Exequiel25/Mezclador-de-4-canales-y-Amplificador-de-3W/README.md

# Mezclador-de-4-canales-y-Amplificador-de-3W
