Exequiel25/Mezclador-de-4-canales-y-Amplificador-de-3W/Proyecto Final EA2-Magni Genre,Exequiel Juan.docx

DEPARTAMENTO ELECTRONICA DE LA FACULTAD REGIONAL MENDOZA

UNIVERSIDAD TECNOLOGICA NACIONAL

UNIVERSIDAD TECNOLÓGICA NACIONAL

Facultad Regional Mendoza

Departamento de Electrónica

Cátedra: Electrónica Aplicada II

“Mezclador de audio con 4 canales,

amplificador de potencia de 3W”

Alumno: Exequiel Juan Magni Genre

N.º Legajo: 46229

Docente titular: Ing. Moyano, Roberto

AÑO 2025

# 1 Definición del problema

Como parte de los requerimientos de aprobación y/o regularización de la materia Electrónica aplicada II se plantea la necesidad de construir un sistema que plasme/aplique los conocimientos adquiridos en dicha materia. Dicho trabajo deberá ser presentado funcionando (simulado) y con su respectivo informe.

## 1.1 Solución propuesta

Construcción de un mezclador de 4 canales e integrarlo con un amplificador de audio. La potencia máxima de diseño para el amplificador de potencia es de 3 Watts valor eficaz.

## 1.2 Justificación

El proyecto abarca gran parte del contenido y conceptos del programa analítico de la materia. Por lo que resulta una buena opción como tema de trabajo final.

Temas incluidos:

- Tema 1: Amplificadores Realimentados
- Tema 2 y 3: Amplificadores Operacionales
- Tema 5: Respuesta en frecuencia
- Tema 6: Amplificadores de Potencia
- Tema 7: Fuentes de alimentación regulada

## 1.3 Objetivos

- Integrar y aplicar los conceptos vistos en la materia y en otras también.

## 1.4 Alcances y limitaciones

El proyecto consistirá en un mezclador de audio y un amplificador de potencia a su salida, ya que un amplificador operacional no sería capaz de suministrar al parlante la corriente necesaria para la excitación de la bobina.

El mezclador deberá ser capaz de manejar entradas de micrófono balanceados, instrumentos musicales y entradas de audio auxiliares (computadoras, celulares, reproductores, etc.). Para este informe y simulación, se realizará el diseño de un canal completo, es decir, con entradas de micrófono, instrumentos, auxiliares y de línea, pero este proyecto puede ser modificado para que cada canal sea más específico a la entrada que se desea.

El amplificador de potencia desarrolla una potencia máxima eficaz de 3W (Watts) sobre un parlante equivalente a una carga de 8Ω (Ohm).

También se debe considerar agregar un amplificador para auriculares cuando el operador desea escuchar la señal de audio de cada canal.

## 1.5 Diagrama de bloques

Figura 1.5.1: Diagrama de bloques general

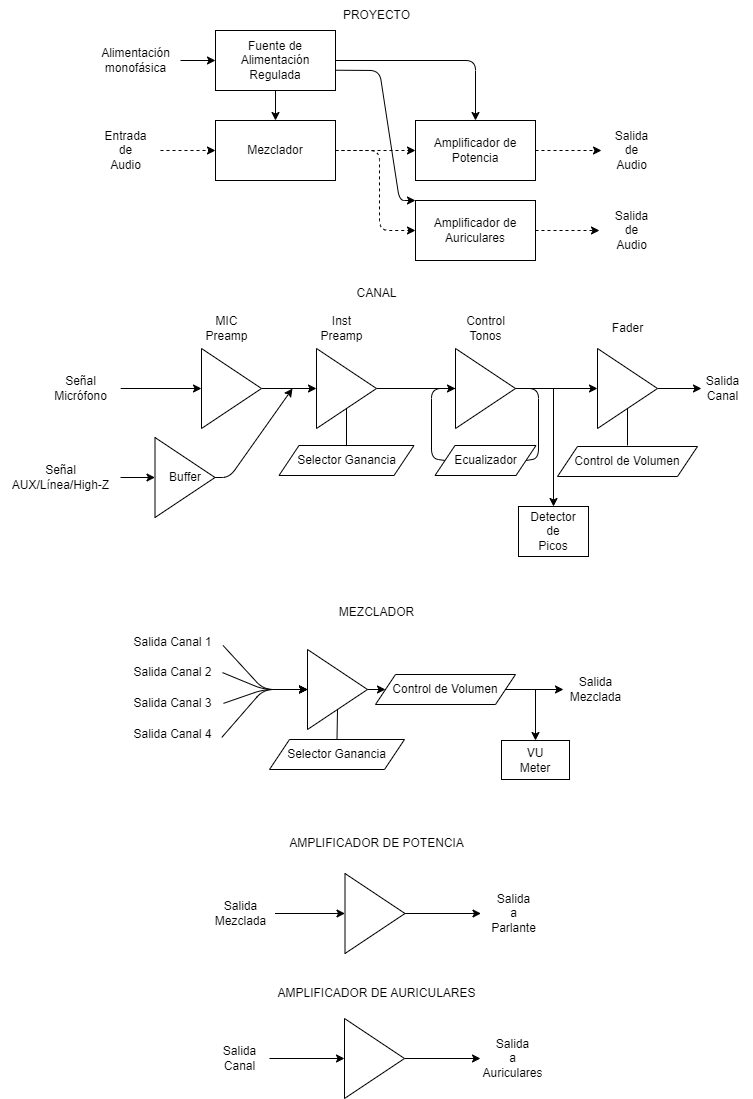
[picture p1: figure]

Figura 1.5.2: Diagrama de bloques fuente de alimentación

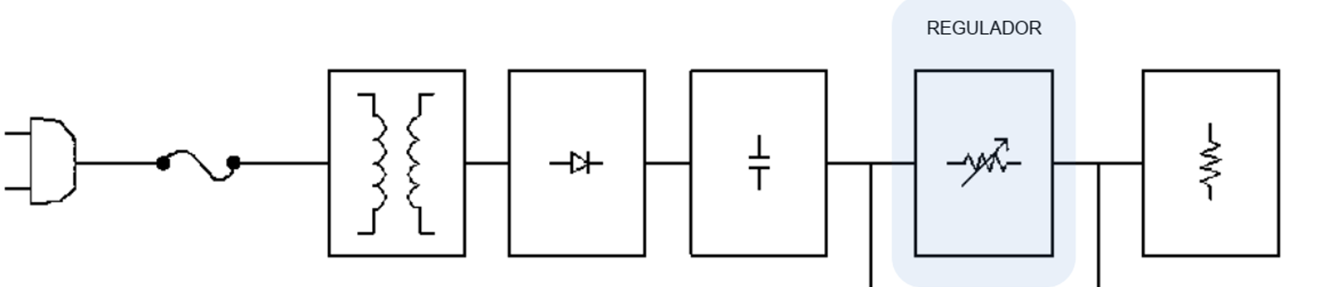
[picture p2: figure]

Figura 1.5.3:Diagrama de bloques en KiCad

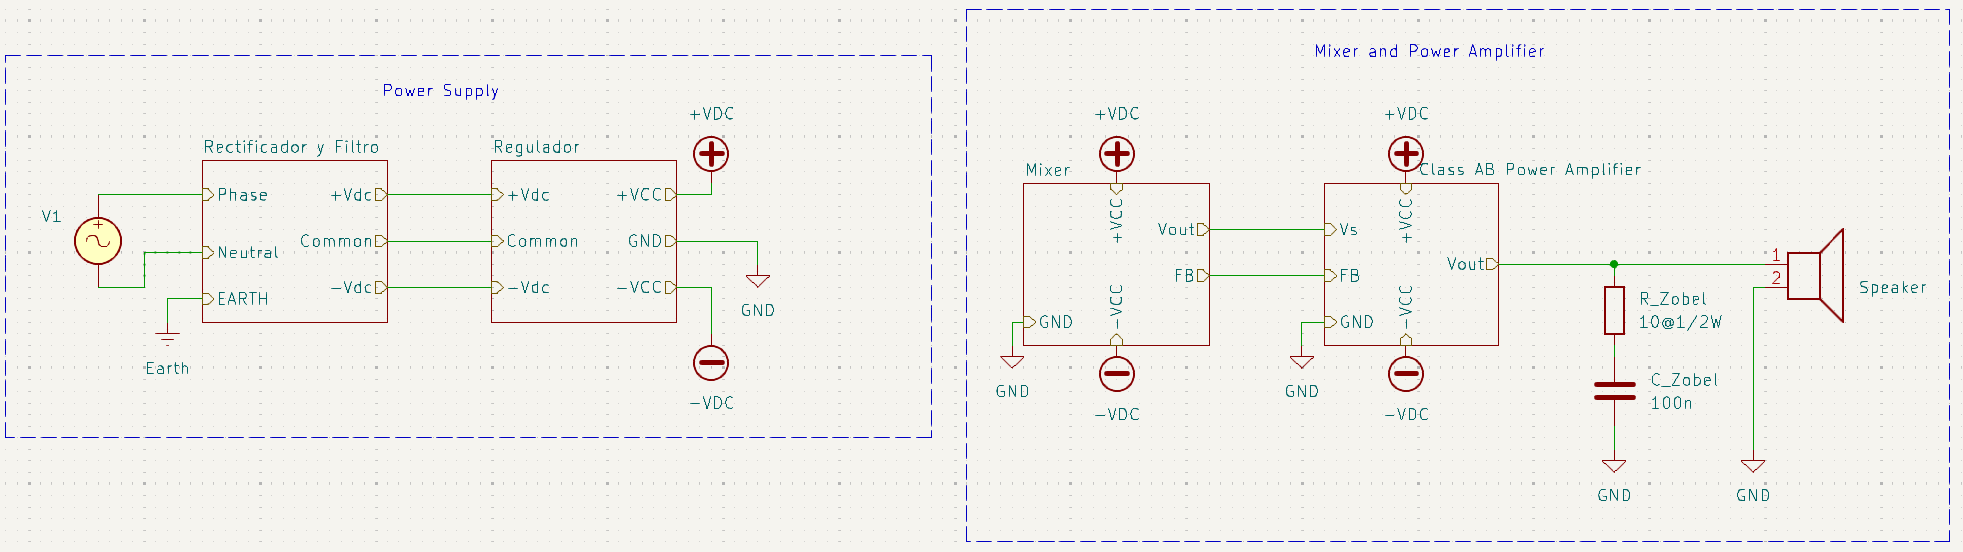
[picture p3: figure]

Figura 1.5.4: Diagrama de bloques de un canal completo

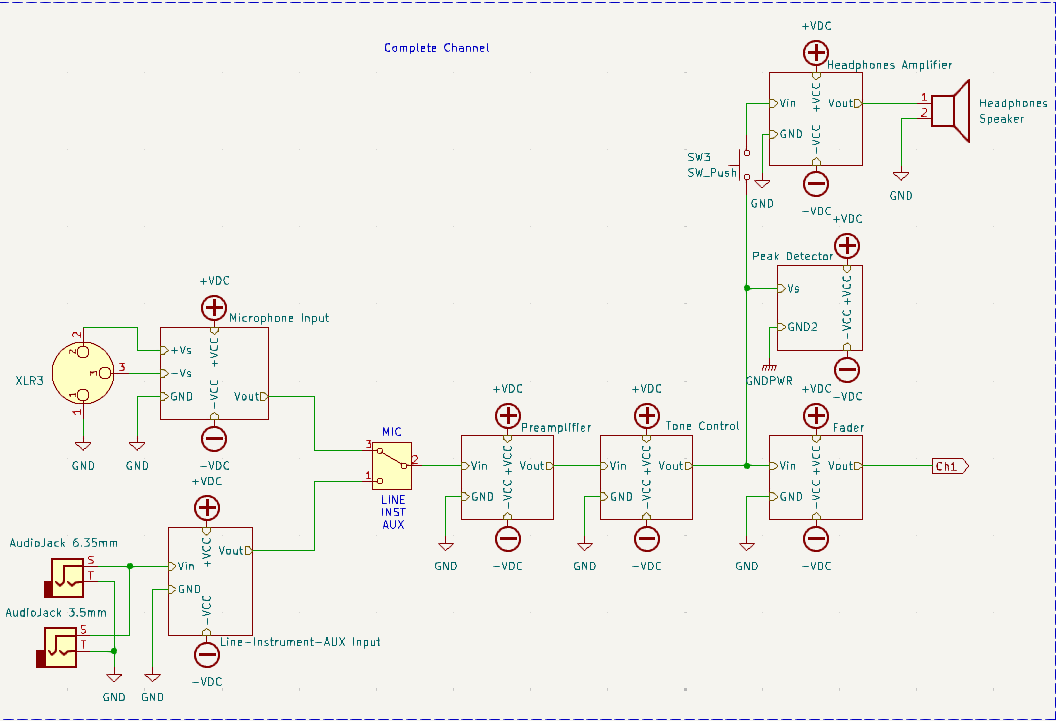
[picture p4: figure]

Figura 1.5.5: Diagrama de bloques etapa sumadora

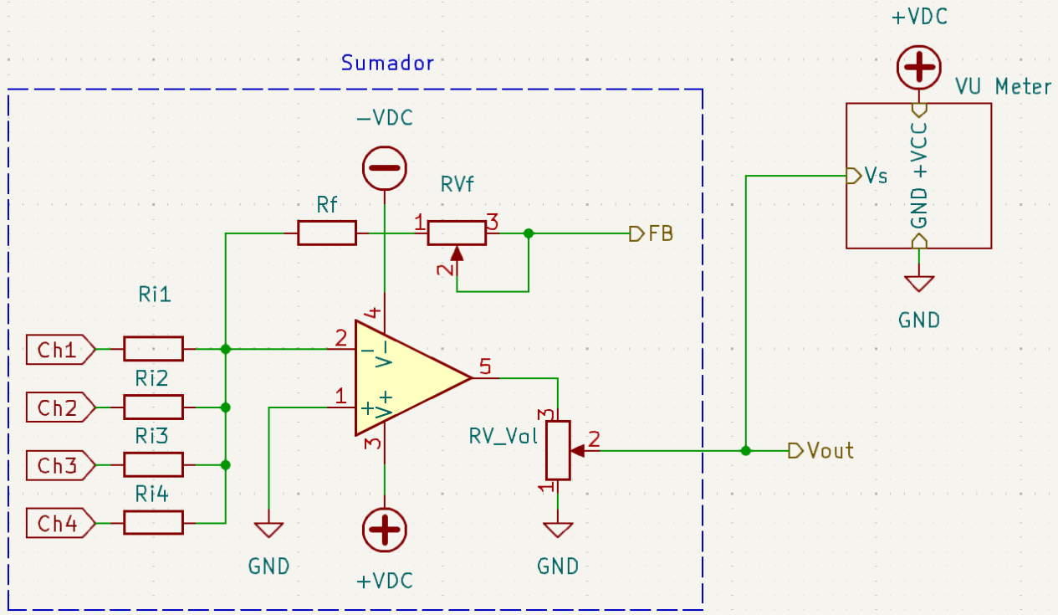
[picture p5: figure]

# 2 Pre-Diseño

## 2.1 Parámetros y consideraciones técnicas

En el desarrollo del proyecto, se realizó una investigación en la construcción de consolas mezcladoras comerciales. De allí, se logró plantear un circuito que cumpla con expectativas y estándares comerciales.

ETAPA ENTRADA

GUITARRA

(eléctrica o

acústica)

CARGA

8 Ω

### 2.1.1 Fuente de alimentación

La fuente que alimenta a los amplificadores no debería ser conmutada, ya que estas introducen ruido en las señales de audio. Por este motivo, se debe optar por una fuente regulada no conmutada.

### 2.1.2 Selección de componentes electrónicos

Al momento de la selección de los componentes electrónicos, se debe buscar que estos no introduzcan ruido al sistema, especialmente en la elección de los amplificadores operacionales, los cuales en sus fichas técnicas suelen indicar el valor de SNR (Relación Señal-Ruido) o indican el nivel de ruido respecto a la señal de entrada.

También se evita en el diseño utilizar resistencias de valores elevados, ya que las mismas introducen ruido térmico al sistema.

### 2.1.3 Valores de tensión

Existen valores estandarizados de tensión, definidos como niveles:

- Nivel de línea: suele ser de -10 dBV (nominal) o +4 dBu (profesional)
- Nivel de micrófonos: es la más débil, entre -60 dBu y -20 dBu
- Nivel de instrumentos: entre -20 dBu y -10 dBu
- Nivel de señal AUX (auxiliar): entre -3.3 dBu y 1.15 dBu

Recordamos:

dBV (DecibeliosVolts)=20⋅log_10 V

dBu (DecibeliosUnidaddeUnidad)=20⋅log_10 (V/0.775)

### 2.1.4 Ancho de banda:

Debemos respetar el ancho de banda de las señales de audio, el cuál consta de una frecuencia mínima de 20 Hz hasta una frecuencia máxima de 20 kHz (espectro audible), aunque en la práctica, el rango suele ser aproximadamente desde los 50 Hz hasta los 18 kHz. Aun así, buscaremos exigencia en respetar el espectro audible.

### 2.1.5 Amplificador de potencia

Utilizaremos un amplificador de audio clase AB. Si bien la potencia planteada es menor comparada a algunas consolas mezcladoras comerciales (comúnmente 100W), plantearemos un diseño cuyo alcance pueda ser expandido con simples modificaciones, pero respetando la topología.

### 2.1.6 Detector de picos

Para el detector de picos se optó por un diseño de detección bipolar, ya que las señales de audio pueden ser muy asimétricas en amplitud y de este modo podremos detectar picos positivos y negativos.

# 3 Amplificador de Potencia

## 3.1 Especificaciones

El amplificador de potencia tiene como objetivo proveer un valor de corriente capaz de excitar el bobinado del parlante, por lo tanto, podemos considerarlo un amplificador de corriente. Es por esto, que se utiliza una configuración de Colector Común o Seguidor de Emisor.

Deberemos cumplir con los siguientes requerimientos:

Potencia: P_L =3W

Carga: R_L =8Ω

Condiciones de máxima transferencia de energía:

Z_i ≪R_S

Z_o =R_L

Los amplificadores Clase AB (Push-Pull) son uno de los diseños de amplificador de audio más preferidos debido a su combinación de eficiencia y alta calidad ya que tienen baja distorsión cruzada y alta linealidad.

## 3.2 Esquemático

Se plantea como solución el siguiente circuito:

Figura 3.2.1:Amplificador de audio clase AB

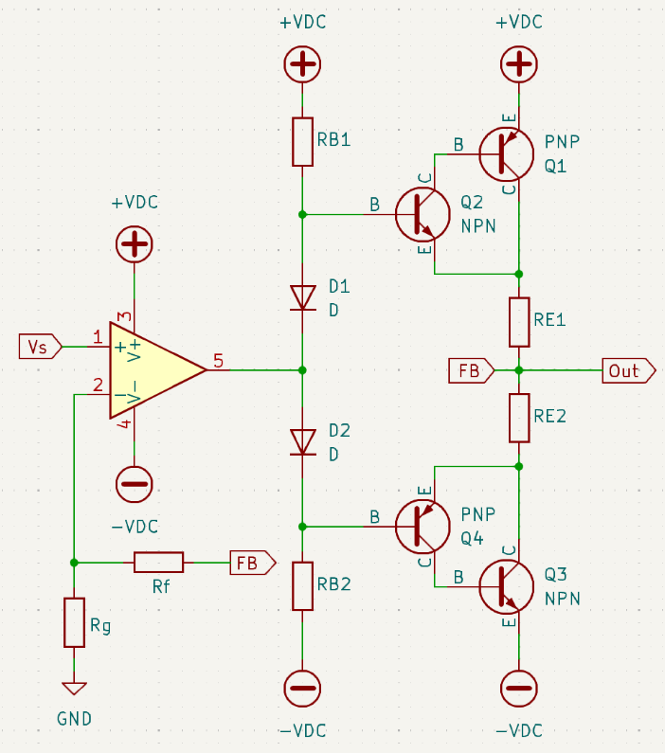
[picture p6: figure]

## 3.3 Observaciones

Utilizamos dos pares Sziklai (o pares complementarios) para reducir el valor de corriente de polarización y de señal extraída desde el amplificador operacional.

Añadimos dos resistencias (RE1 y RE2) para evitar un embalamiento térmico.

Unimos la red de realimentación del amplificador operacional a la salida del amplificador de potencia para compensar las alinealidades y las caídas de tensión irregulares en los diodos y junturas, así aseguramos un nivel nulo de continua en la salida.

## 3.4 Cálculo

### 3.4.1 Potencia en la carga

Primero determinamos los valores de tensión y corriente en la carga.

| P_L =(V_L^2)/(R_L)=I_(L_max)^2 ∙R=3W | (1)
| V_(L_max) ≈4.9V≈6.93V_p | (2)
| I_(L_max) ≈0.61A≈0.87A_p | (3)

Consideramos que V_(cc) ≥V_(L_max) , debido a que V_(cc) es el máximo nivel de desviación en la carga y, por lo tanto, podríamos seleccionar una fuente de 5V. Sin embargo, como utilizaremos la misma fuente tanto para el amplificador de potencia, como para los amplificadores, se decide una tensión de fuente de V_(cc) =±15V .

### 3.4.2 Análisis de Corriente Alterna

Para el diseño de esta etapa recordamos que, para la configuración de seguidor de emisor, la ganancia de tensión es unitaria A_v ≈1 , por lo tanto, la tensión de la carga será responsabilidad de la etapa anterior.

- Q1: TIP32C
  - h_(FE_(min)) =25
  - Valores máximos:
    - V_(CE) =40V
    - I_C =3A
- Q2: 2N3904
  - h_(FE_(min)) =100
  - Valores máximos:
    - V_(CE) =40V
    - I_C =200mA
- Q3: TIP31C
  - h_(FE_(min)) =25
  - Valores máximos:
    - V_(CE) =40V
    - I_C =3A
- Q4: 2N3906
  - h_(FE_(min)) =100
  - Valores máximos:
    - V_(CE) =40V
    - I_C =200mA

Cuando el par Sziklai superior esté polarizado, el inferior estará en reposo. Por lo que podemos partir de esa suposición para comenzar el análisis. Desde la malla de salida, podemos decir que la corriente de carga será la corriente de emisor del par Sziklai,

| I_(L_p) =I_(E1) ≈0.87A | (4)

Además, podemos conocer la corriente de base, a partir del valor de ganancia de corriente del transistor.

| β_(Sziklai) =β_(Q1) ⋅β_(Q2) +β_(Q1) | (5)

Si tomamos los valores mínimos que figuran en las hojas de datos:

| β_(Sziklai) =25*100+25=2525 | (6)

Por lo tanto,

| I_(B1) =(I_(E1))/(β_(Sziklai))=(0.87A)/2525≈344.55μA | (7)

Si asumimos que, por los diodos, habrá una circulación de 1mA :

| I_(Bias) =I_(B1) +I_D =344.55μ+1mA≈1.34mA | (8)

Debemos ahora calcular la tensión en la base:

| V_D =V_(L_p) -V_(RE1) -V_(Sziklai) | (9)
| V_D =6.93V-(0.87A⋅0.33Ω)-0.7V=5.94V | (10)

Ahora podemos calcular el valor de R_(B1) como:

| R_(B1) =(V_(CC) -V_D)/(I_(Bias)) | (11)
| R_(B1) =(15V-5.94V)/(1.34mA)≈6761Ω→6.8kΩ | (12)

De manera análoga para el par Sziklai inferior:

| R_(B2) =R_(B1) =6.8kΩ | (13)

## 3.5 Simulación

Simularemos únicamente la etapa sin realimentación con el sumador, ya que este aún no está diseñado. Luego, se realizará la simulación correspondiente con ambas etapas.

Figura 3.5.1

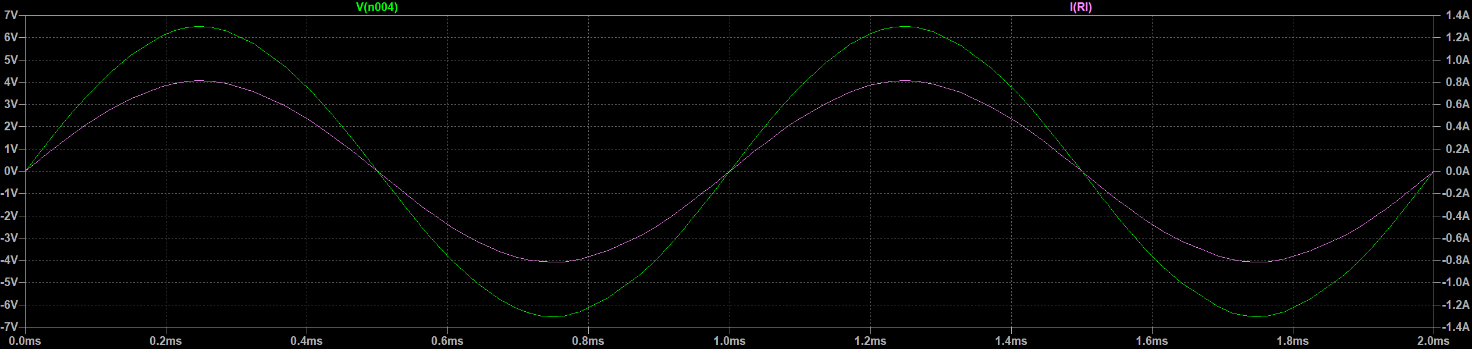
[picture p7: figure]

V_s = 6.93V pico y la salida es V_o = 6.51V pico. Implica Av=0.939, que habrá que compensar adelante. I_o = 813.73mA pico, cuando I_L es 870mA

Figura 3.5.2: Respuesta en frecuencia

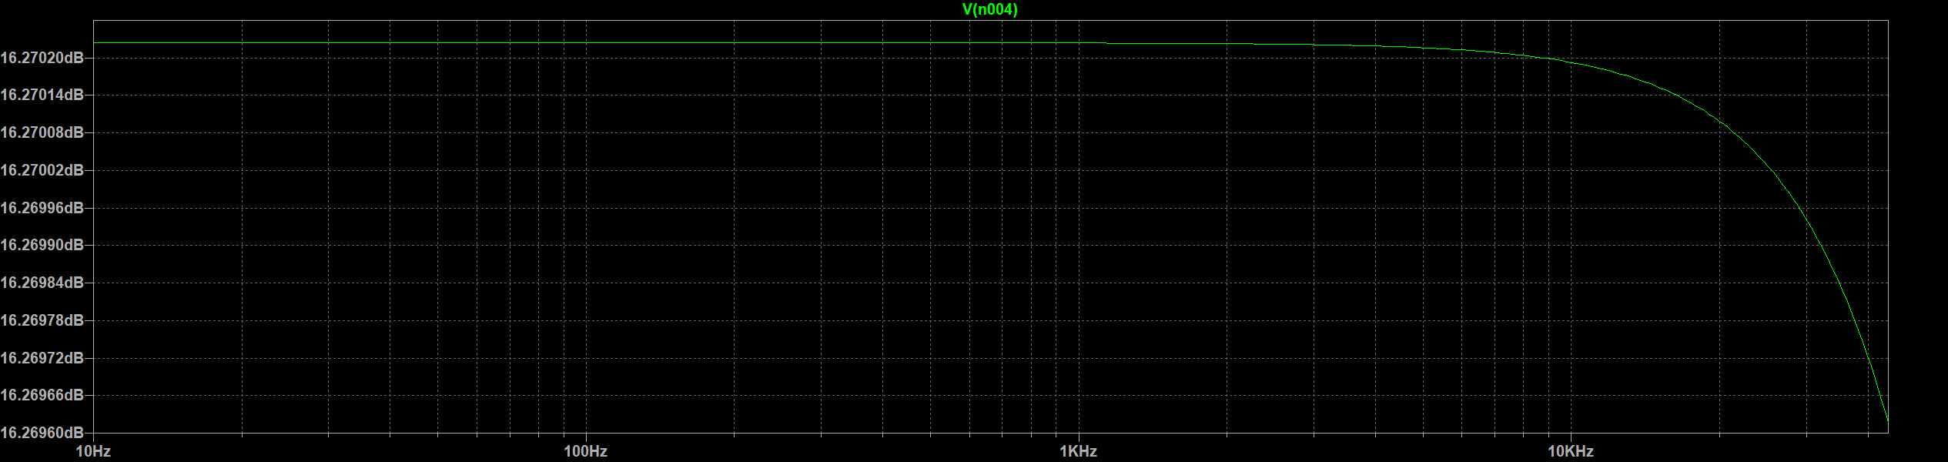
[picture p8: figure]

Como no hemos incorporado capacitores, la respuesta de la etapa tiene un ancho de banda más amplio del establecido.

## 3.6 Resumen de la etapa

Figura 3.6.1: Esquemático resultante

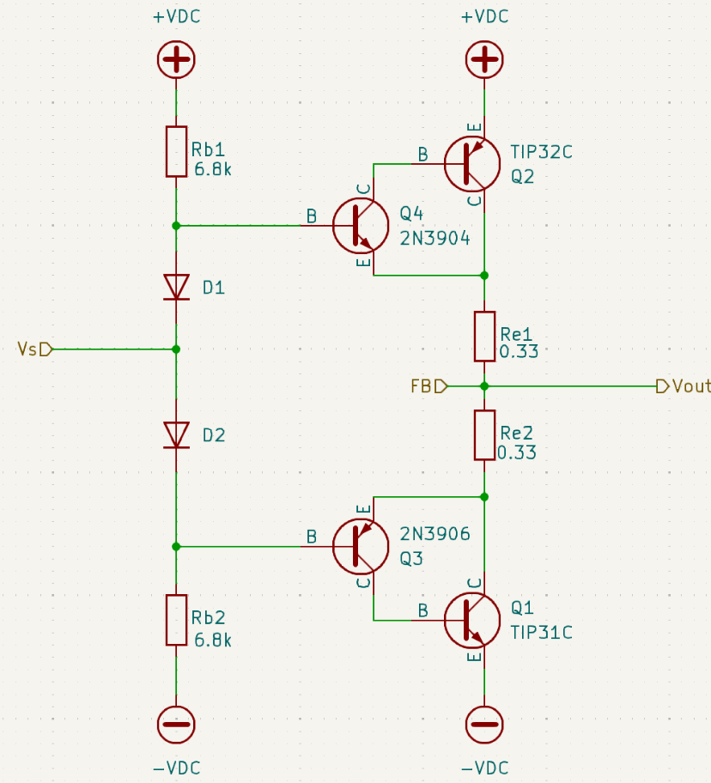
[picture p9: figure]

Tabla 1: Componentes de la etapa

Componente | Valor | Número de Ecuación
R_(e1) ,R_(e2) | 0.33 Ω
R_(b1) ,R_(b2) | 6.8 kΩ | (12)

# 4 Mezclador de Audio (Mixer)

## 4.1 Introducción

Para el diseño del mezclador, se determina de primera instancia qué niveles tienen las señales que han de ser mezcladas, y cuánta ganancia es requerida por canal y a nivel general. Siendo que se utilizarán principalmente entradas de micrófono y de instrumentos, se decide como primera medida, adaptar el nivel de micrófono al nivel de instrumento. De esta forma, se comparte el resto del canal para ambas señales. El objetivo entonces será poder llegar a un nivel de línea luego de la etapa preamplificadora.

Si quisiéramos agregar al canal, entradas auxiliares (AUX) o de línea, podemos hacerlo antes del preamplificador de instrumento.

## 4.2 Sumador “MASTER”

### 4.2.1 Especificaciones

El sumador es la última etapa del mezclador antes del amplificador de potencia. Sabiendo que el amplificador de potencia no tiene ganancia de tensión, implica que la tensión máxima que queremos desarrollar nosotros en la carga, será la tensión máxima de salida del sumador:

v_o =V_L =4V

Si bien veremos que, en la etapa del atenuador (“fader”), se le puede dar un “boost” a la señal, tomaremos como tensión máxima de entrada los 1.228Vrms, equivalentes a la tensión de línea.

### 4.2.2 Esquemático

Figura 4.2.1: Etapa sumador

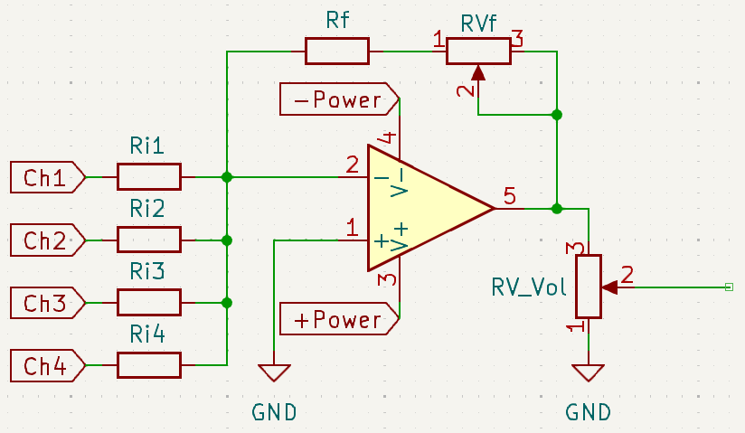
[picture p10: figure]

### 4.2.3 Observaciones

El diseño del sumador es bastante sencillo. El añadido de un potenciómetro en la red de realimentación es el control de ganancia del todos los canales, y el potenciómetro a la salida antes de ingresar a la etapa de potencia controla el volumen general. Una lógica similar será aplicada en cada canal.

### 4.2.4 Cálculo del amplificador

De las especificaciones, sabemos que

| V_(L_(RMS)) =4.9V | (14)
| v_s =1.228V_(RMS) | (15)

Sin embargo, debemos recordar que las señales de cada canal se adicionan, por lo que, para evitar una tensión superior a la deseada para V_(L_(RMS)) , deberemos distribuir la tensión máxima de entrada por canal:

| v_i _(sumador) =(v_s)/(Número Canales) | (16)

Es decir, que cada canal tendrá una tensión de salida de

| v_(o_(canal)) =v_(i_(sumador)) =0.307V_(RMS) | (17)

Esta tensión, la volveremos a utilizar en el diseño del preamplificador.

Debemos recordar que la etapa amplificadora no posee una ganancia de tensión unitaria, como lo vimos en las simulaciones Figura 3.5.1. De todas formas, observaremos lo que ocurre al incluir la red de realimentación a la salida. Si esto no mejora en la simulación, se deberá calcular una ganancia de compensación.

Silenciando todos los canales, para un canal, la ganancia de sumador será

| |G|=(v_o)/(Número Canales⋅v_(s_(ch1))) | (18)

Nuestra ganancia será entonces:

| |G|=(4.9V_(RMS))/(4*0.307V_(RMS))≈3.99→G_(dB) ≈12dB | (19)

Por pedido del usuario, se agrega la posibilidad de atenuar la señal, por lo que el rango de ganancia propuesto es:

| -10dB≤|G_(dB) |≤12 dB→ 0.316≤|G_(dB) |≤3.99 | (20)

Debido a que las impedancias de salida de los canales no serán muy altas, podemos establecer resistencias de entrada de un valor relativamente bajo (para disminuir ruido térmico). Esto a su vez, limita el valor del potenciómetro, el cual tiene una relación proporcional (aumentar el potenciómetro, implica aumentar las resistencias de entrada).

Sabiendo que:

| v_o =-(R_f +R_(Vf) )((V_(ch1))/(R_(i1))+(V_(ch2))/(R_(i2))+(V_(ch3))/(R_(i3))+(V_(ch4))/(R_(i4))) | (21)

Al determinar R_(i1) =R_(i2) =R_(i3) =R_(i4) =R_i , podemos determinar la ganancia para un canal como:

| G=-(R_f +R_(Vf))/(R_i) | (22)

Tenemos el siguiente sistema de ecuaciones:

| , {, -(R_f +R_(Vf))/(R_i)=-3.99, -(R_f)/(R_i)=-0.316 | (23)

Reescribimos:

| , {, R_f -3.99R_i =-R_(Vf) , R_f -0.316R_i =0 | (24)

Elegimos un valor conveniente para R_(V_f) :

| R_(V_f) =10kΩ | (25)

Ahora tenemos un sistema de 2 ecuaciones y 2 incógnitas. Resolviendo:

| R_f ≈860Ω→1kΩ | (26)
| R_i ≈2722Ω→2.7kΩ | (27)

El rango de ganancia con los valores de resistencias comerciales será de:

| 0.29≤|G|≤4.22 | (28)
| , -10.75dB≤G_(dB) ≤12.51dB | (29)

Finalmente, seleccionamos el potenciómetro deslizable para el control de volumen:

| R_(V_(vol)) =10kΩ | (30)

### 4.2.5 Simulación

Observamos todos los valores posibles con las variaciones de R_(V_f) y R_(V_(vol)) , con una señal de entrada en un canal de 0.307V_(RMS) .

Figura 4.2.2: Posibles valores con variaciones de ambos potenciómetros

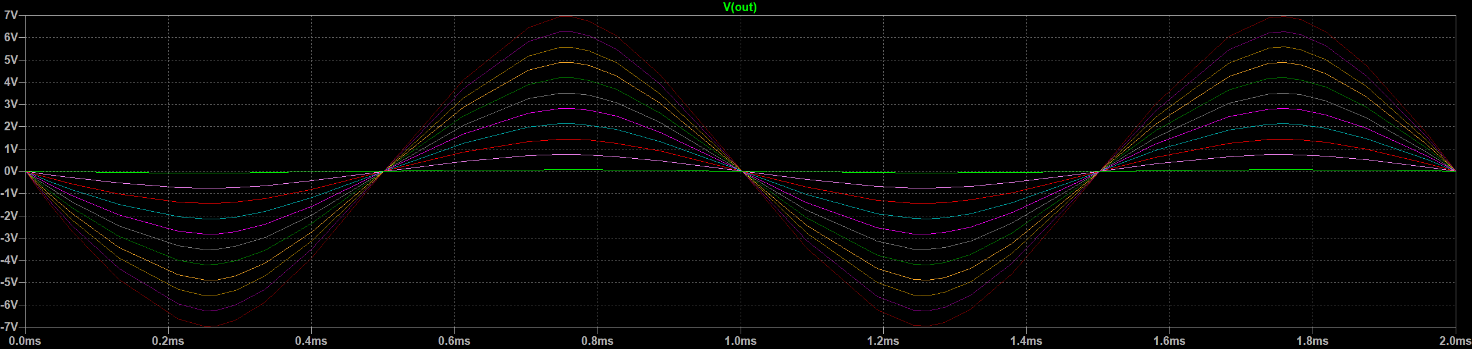
[picture p11: figure]

Valor mínimo 70.22 mV, Valor máximo 6.95 Vp

Figura 4.2.3: Respuesta en frecuencia con variaciones de ambos potenciómetros

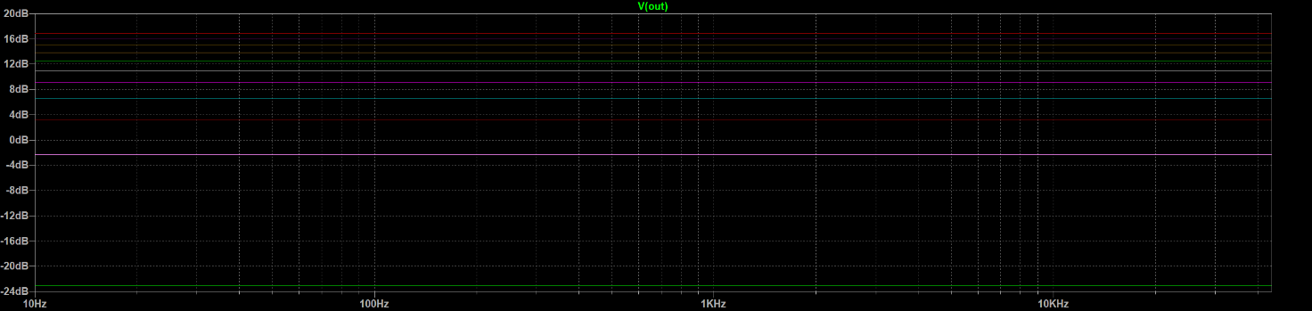
[picture p12: figure]

Vemos también que la respuesta en frecuencia es plana para todas las posibilidades.

También simulamos esta etapa con el Amplificador de Potencia.

Figura 4.2.4: Potencia máxima sobre la carga

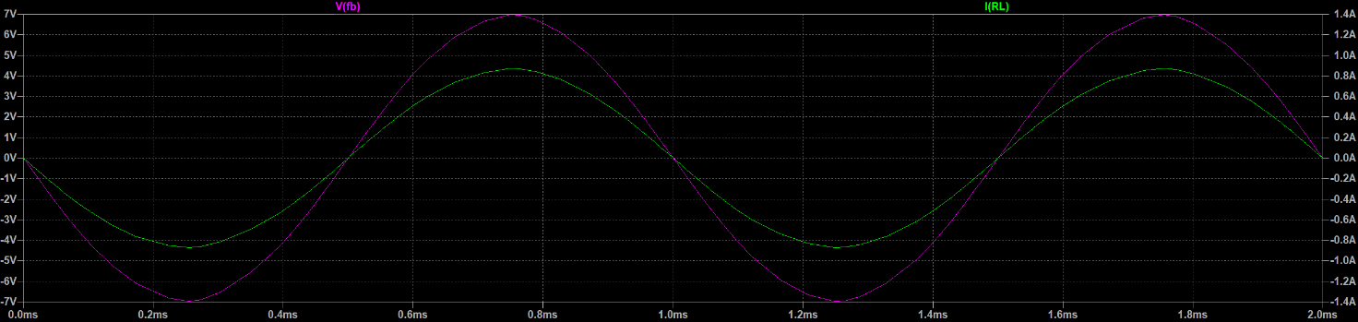
[picture p13: figure]

V_Lmax = 6.96V (por encima de lo deseado), I_Lmax=870.88mA

Confirmamos que los transistores son capaces de disipar la potencia desarrollada en ellos.

Figura 4.2.5:Corriente en resistencias RE1 y RE2

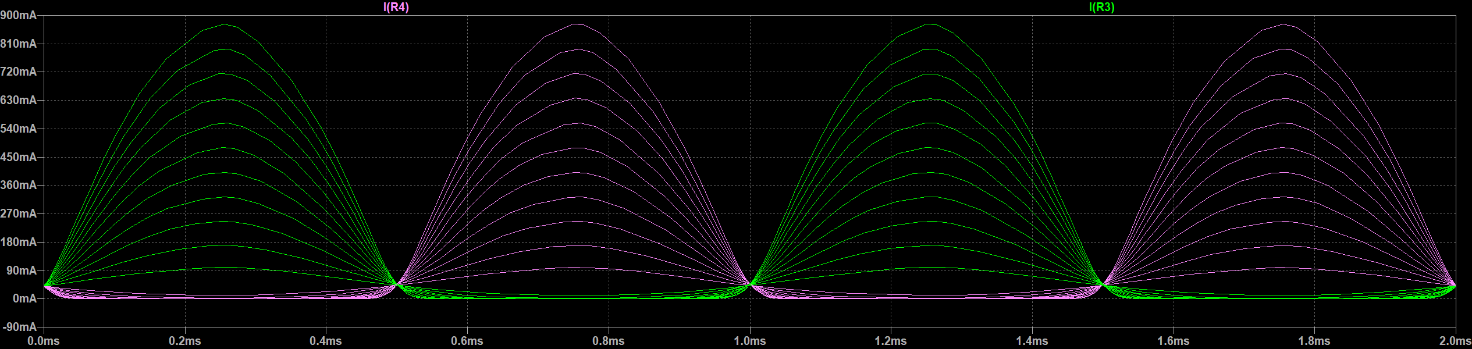
[picture p14: figure]

Figura 4.2.6: Tensiones sobre RE1 y RE2

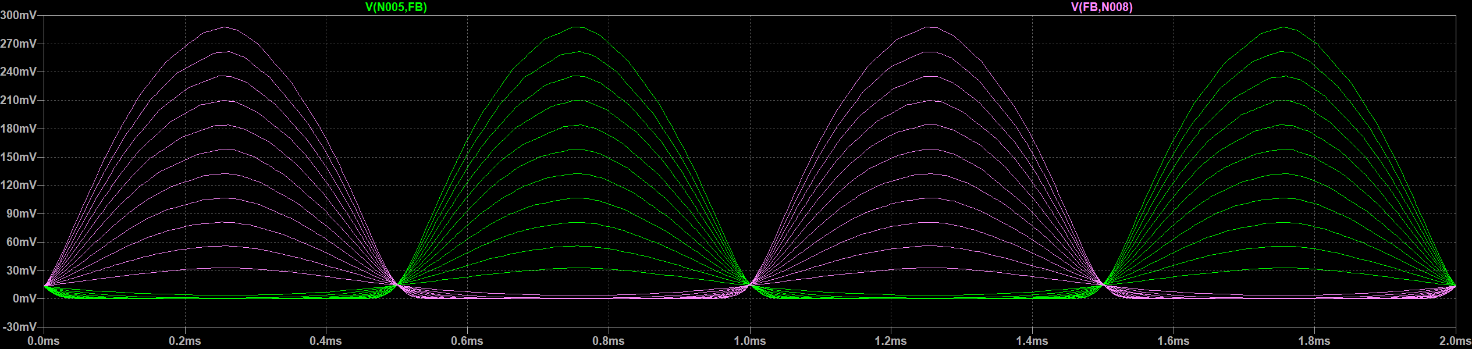
[picture p15: figure]

Figura 4.2.7: Curvas tensión y corriente -Posibles valores

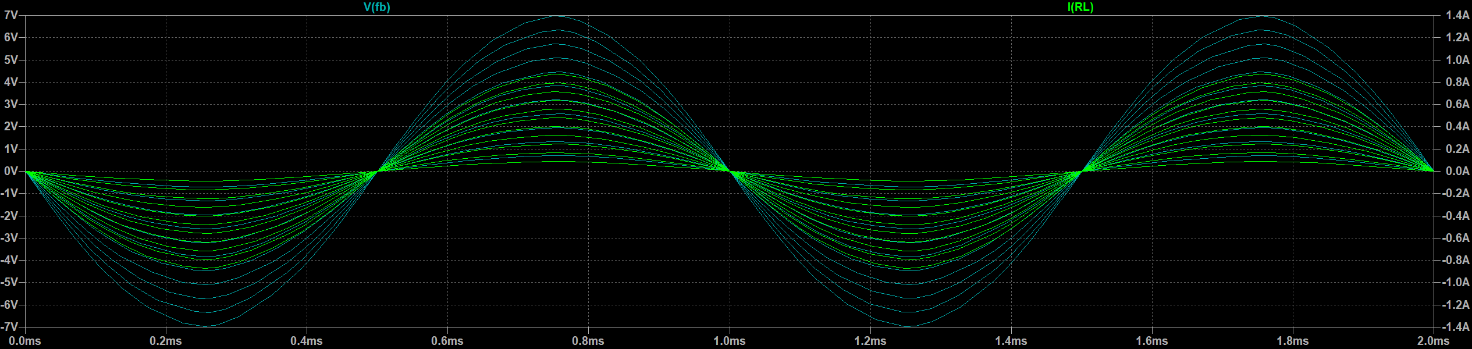
[picture p16: figure]

La potencia máxima por disipar en el par Sziklai 6.74W, con I= 857.02mA, V= 7.87V

### 4.2.6 Resumen de la etapa

Figura 4.2.8: Esquemático resultante

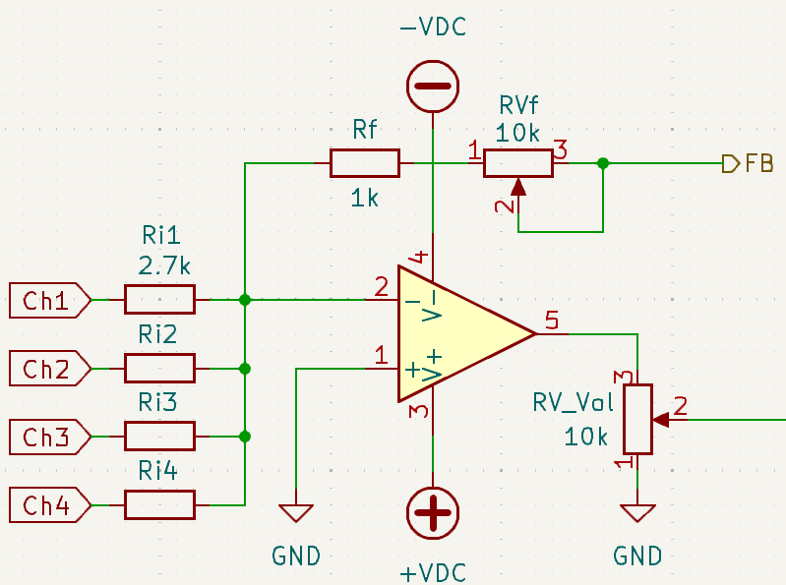
[picture p17: figure]

Tabla 2: Componentes de la etapa

Componente | Valor | Número de Ecuación
R_(i1) , R_(i2) , R_(i3) , R_(i4) | 2.7 kΩ | (27)
R_f | 1 kΩ | (26)
RV_f , RV_(Vol) | 10 kΩ | (25)(30)

## 4.3 Preamplificador de Instrumento (Inst.) + Line + AUX

### 4.3.1 Especificaciones

El preamplificador de instrumentos será útil no sólo para estos, sino también para señales de línea y AUX (auxiliares). Además, para permitir la adaptación a estas señales, se utiliza un op amp buffer a la entrada, por lo que será un preamplificador considerado como “High-Z” (de alta impedancia). Los datos para tener en cuenta en el diseño son:

Tensión de señal:

-30 dBu≤v_s ≤ -10 dBu

es decir,

24.5mV≤v_s ≤245.08mV

34.65 mV≤v_(s_p) ≤346.6mV

Impedancia de señal:

5kΩ≤Z_(Inst) ≤15kΩ

### 4.3.2 Esquemático

Figura 4.3.1: Etapa de entrada y preamplificador

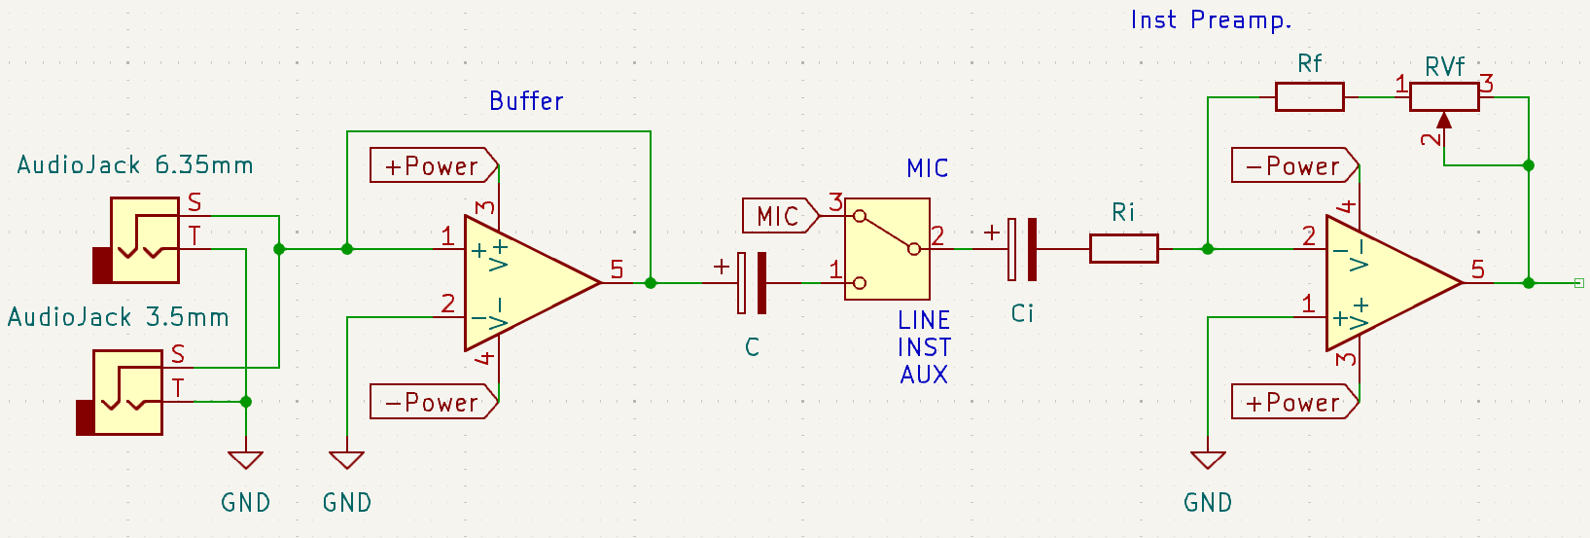
[picture p18: figure]

### 4.3.3 Observaciones

Como se mencionó anteriormente, el buffer a la entrada convierte al canal en uno de alta impedancia (desde el instrumento), lo cual implica una mejor transferencia de tensión. Para evitar problemas entre instrumentos y micrófonos, la conexión al preamplificador se realiza por medio de un switch.

En la solución planteada del preamplificador, no hemos introducido capacitores para determinar el ancho de banda de la etapa, por lo que veremos más adelante cuál es su cálculo.

### 4.3.4 Cálculo

La resistencia R_i es responsable de determinar la impedancia de entrada, nuevamente se encuentra presente la relación de compromiso entre disminuir efectos de carga y mantener bajo ruido. Siendo que la señal fue precedida por una entrada buffer o por el preamplificador balanceado, podemos estimar que la Z_o será de unos pocos ohmios, por lo que podemos determinar un valor beneficioso para el cálculo de ganancia.

| R_i =1kΩ | (31)

Para el cálculo de ganancia, tomamos el peor caso (tensión de señal más bajo) y la máxima tensión que deseamos a la salida. Llevamos la señal desde un nivel de instrumento a un nivel de línea:

| v_s = -30dBu→v_s =24.5mV→v_(s_p) =34.65mV | (32)

Recordando la ecuación (17), nuestra tensión de salida objetivo será

| v_o = 0.307V_(RMS) →v_(o_p) ≈434.16mV→v_o ≈-8dBu | (33)

Por lo tanto:

| |G|≈12.53→|G_(dB) |=21.96dB | (34)

Esta es la ganancia en el caso más desfavorable. Siendo que, en esta etapa, se desea una ganancia variable, debemos determinar el nivel mínimo y máximo de ganancia. Por deseos del usuario, también se debe posibilitar una atenuación de la señal (ganancia entre 0 y 1). El rango de ganancia establecido es:

| -20dB≤|G_(dB) |≤+22dB | (35)

Para nuestro preamplificador:

| | G=-(R_f +R_(Vf))/(R_i) | | (36)
| , {, R_f -12.59R_i =-R_(Vf) , R_f -0.1R_i =0 | | (37)

Elegimos un valor conveniente para R_(V_f) :

| R_(Vf) =50kΩ | (38)

Resolviendo (37):

| R_f ≈400Ω→390Ω | (39)
| R_i ≈4003Ω→3.9kΩ | (40)

Recalculando el intervalo de ganancia:

| 0.1≤|G|≤12.92 -20dB≤|G_(dB) |≤+22.23dB | (41)

Respecto a la elección del op amp, se elige el LM387 debido principalmente a sus características de bajo ruido y que se integran dos op amps, por lo que podremos usar un único IC para el buffer y el preamplificador.

### 4.3.5 Respuesta en frecuencia

Realizamos lo cálculos de los capacitores para que el ancho de banda del preamplificador sea desde 20 Hz hasta 20 kHz.

Para el capacitor de acople:

| f_c =1/(2πRC)→C=1/(2πRf_c) | (42)
| C_i =1/(2π*3.9kΩ*20Hz)≈2.04μF→ 2.2μF | (43)

Agregamos un capacitor en paralelo a las resistencias de realimentación para filtrar las altas frecuencias.

| C_f =1/(2π*(390+50k)Ω*20kHz)≈158pF→150pF | (44)

El capacitor de acople con la siguiente etapa ya se incluye más adelante.

### 4.3.6 Simulación

Para la simulación se obtuvo V_o =452.6mV_p , con error relativo ε_(%) =(452.6mV-434.16mV)/(434.16mV)×100≈4.25% cuando el potenciómetro se encuentra al 100%, y V_o =3.5mV_p para potenciómetro al 0%

Figura 4.3.2: Potenciómetro 100%

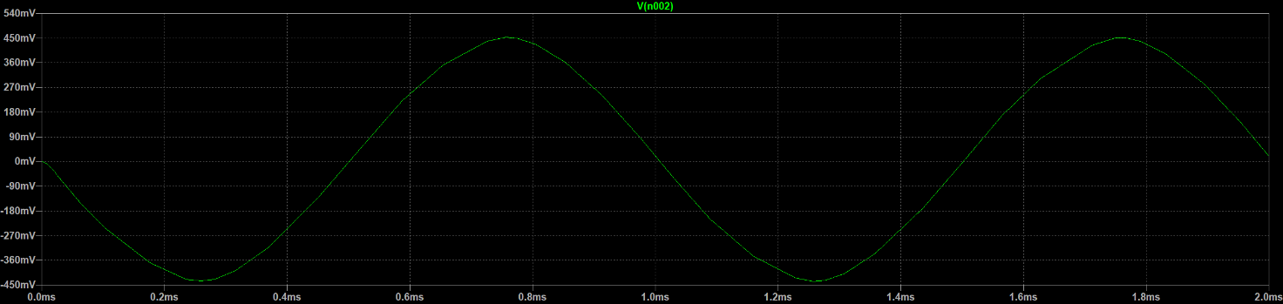
[picture p19: figure]

Figura 4.3.3: Potenciómetro 0%

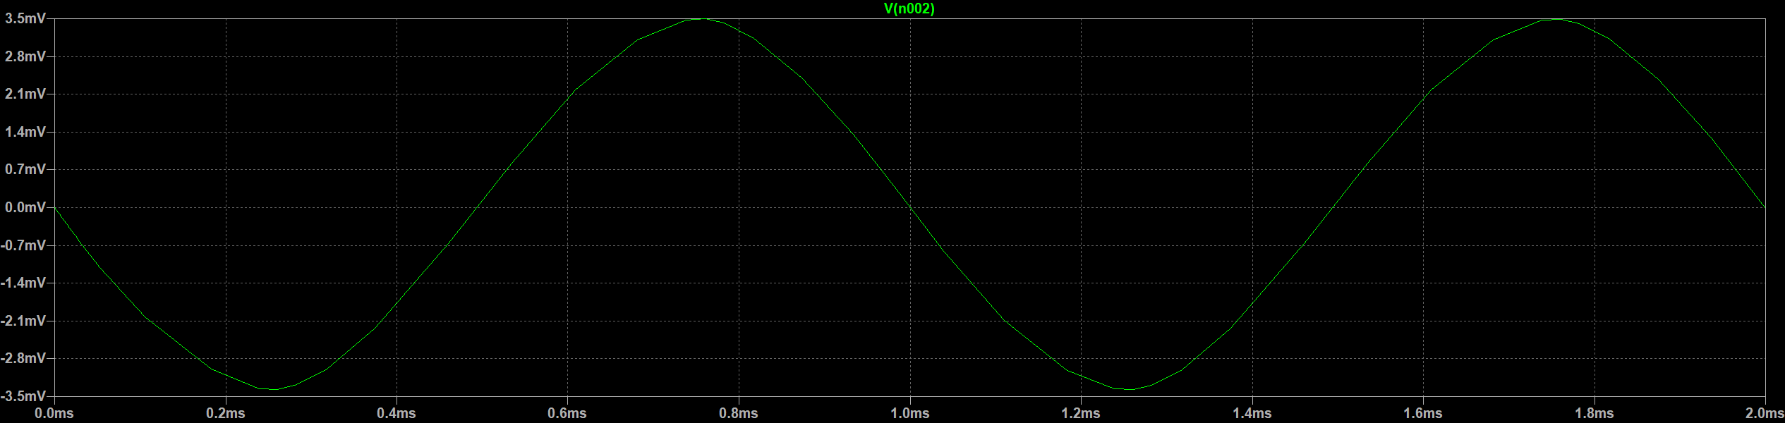
[picture p20: figure]

Figura 4.3.4: Respuesta en frecuencia

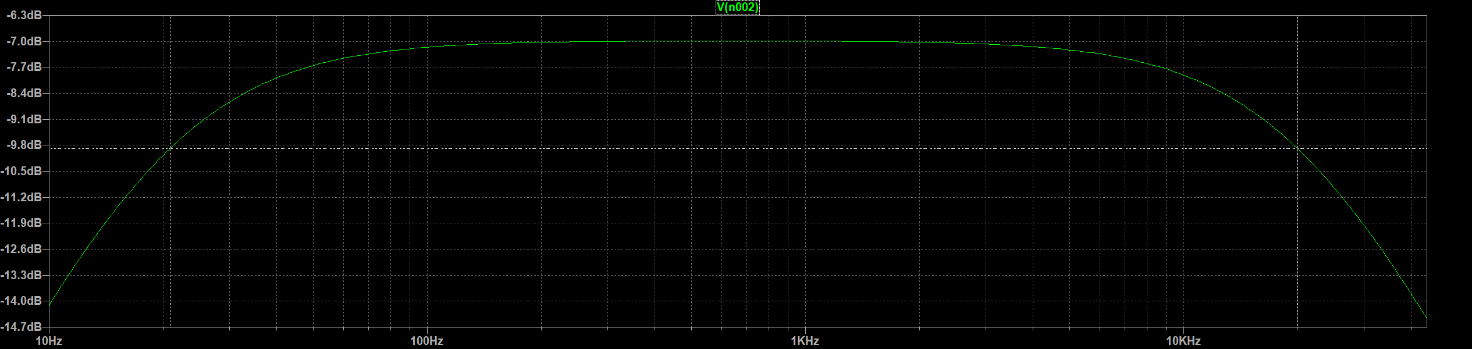
[picture p21: figure]

Ancho de banda en la simulación: BW= 20.04kHz- 20.89Hz

### 4.3.7 Resumen de la etapa

Figura 4.3.5: Esquemático resultante

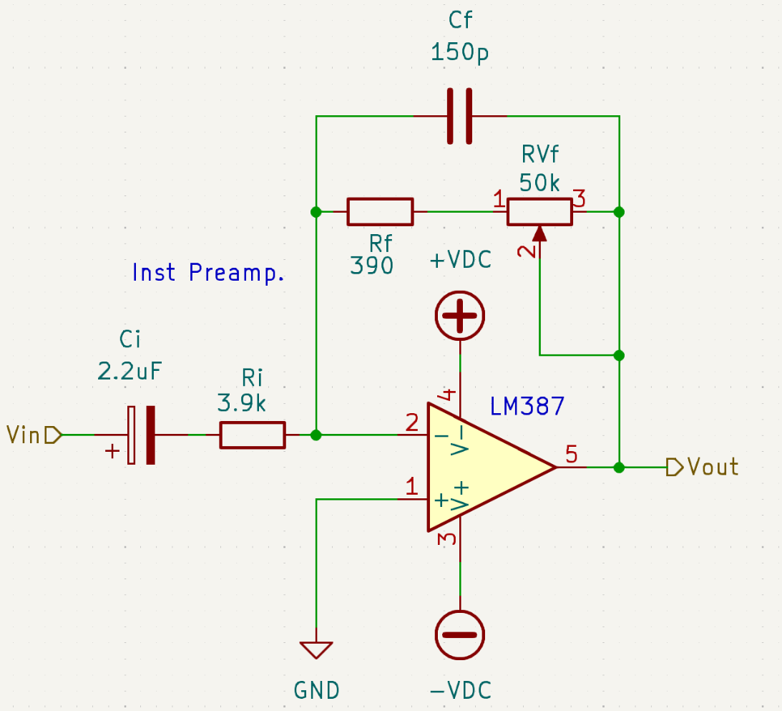
[picture p22: figure]

Tabla 3: Componentes de la etapa

Componente | Valor | Número de Ecuación
R_i | 3.9 kΩ | (40)
R_f | 390 Ω | (39)
RV_f | 50 kΩ | (38)
C_i | 2.2 µF | (43)
C_f | 150 pF | (44)

## 4.4 Preamplificador de Micrófono (MIC)

### 4.4.1 Especificaciones

El preamplificador de Micrófonos es balanceado. Los datos para tener en cuenta en el diseño son los siguientes:

Tensión de señal

-60 dBu≤v_s ≤ -40 dBu

es decir,

775µV≤v_s ≤7.75mV

1.096 mV≤v_(s_p) ≤10.96mV

Impedancia de señal

Z_(MIC) ≈150Ω

### 4.4.2 Esquemático

Se plantea como solución el siguiente circuito:

Figura 4.4.1: Entrada balanceada de micrófono

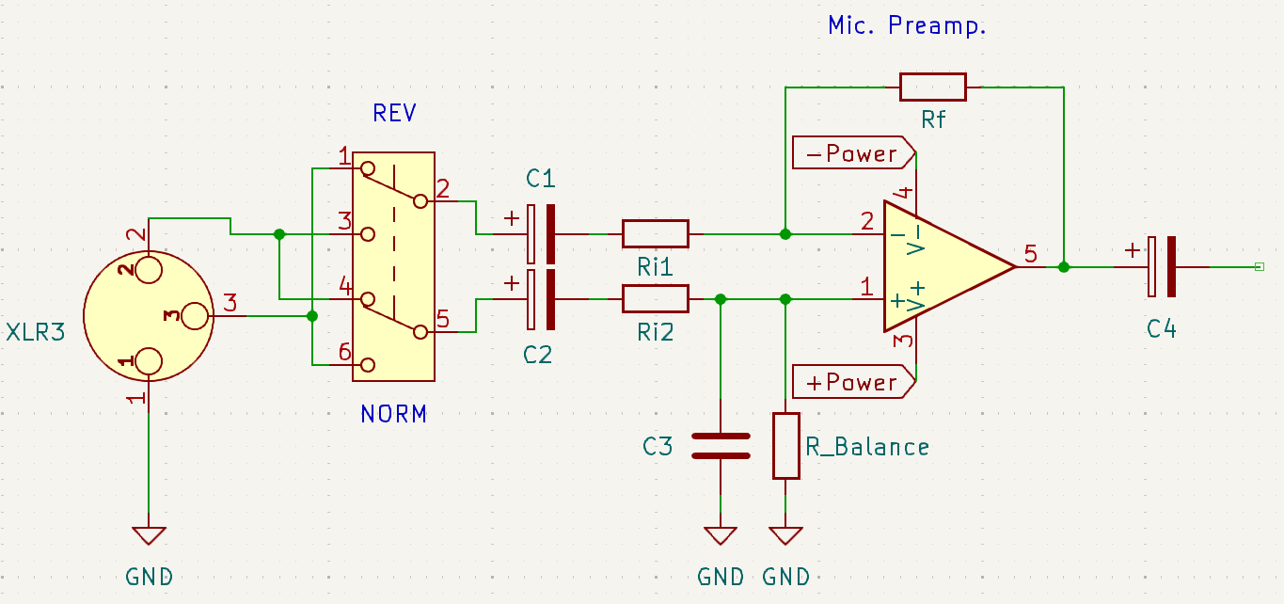
[picture p23: figure]

### 4.4.3 Observaciones

El diseño planteado consta de:

- Un conector hembra estándar Cannon XLR
- Un interruptor para invertir la fase de la señal: usado cuando dos micrófonos se usan en cercanía y producen cancelación de fase debido a la distancia relativa, lo que produce un sonido desagradable
- Capacitores bloqueantes de señal continua
- Amplificador operacional como preamplificador balanceado sin transformador: para la selección del op amp, se debe tener en cuenta su capacidad de rechazo en modo común, cuantificada por la relación de rechazo en modo común (CMRR)

Para obtener mejor resultados, sería conveniente utilizar un transformador para balancear la entrada como se muestra en la Figura 4.4.2, y no realizar un balance electrónico. Además, este método mejora la supresión de ondas de interferencia en radiofrecuencia. La desventaja de este método es que, al trabajar con señales de audio, el transformador debería ser de muy buena calidad para no introducir ruido, lo que implica un costo elevado, además de que introduce cierto nivel de distorsión armónica.

Figura 4.4.2: Circuito de entrada balanceada con transformador

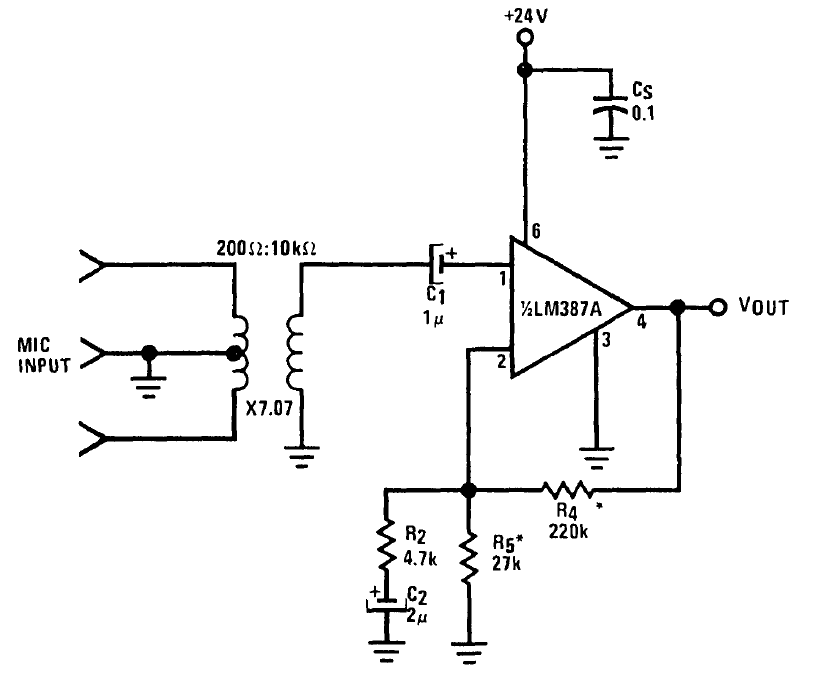
[picture p24: figure]

El circuito podría adaptarse a micrófonos de condensador añadiendo una alimentación “fantasma” (o Phantom), que suele ser de +48V, como se muestra en la Figura 4.4.3. En el caso de optar por este diseño, se le deben añadir diodos de protección.

Figura 4.4.3: Esquemático de entrada con alimentación Phantom y circuito de protección

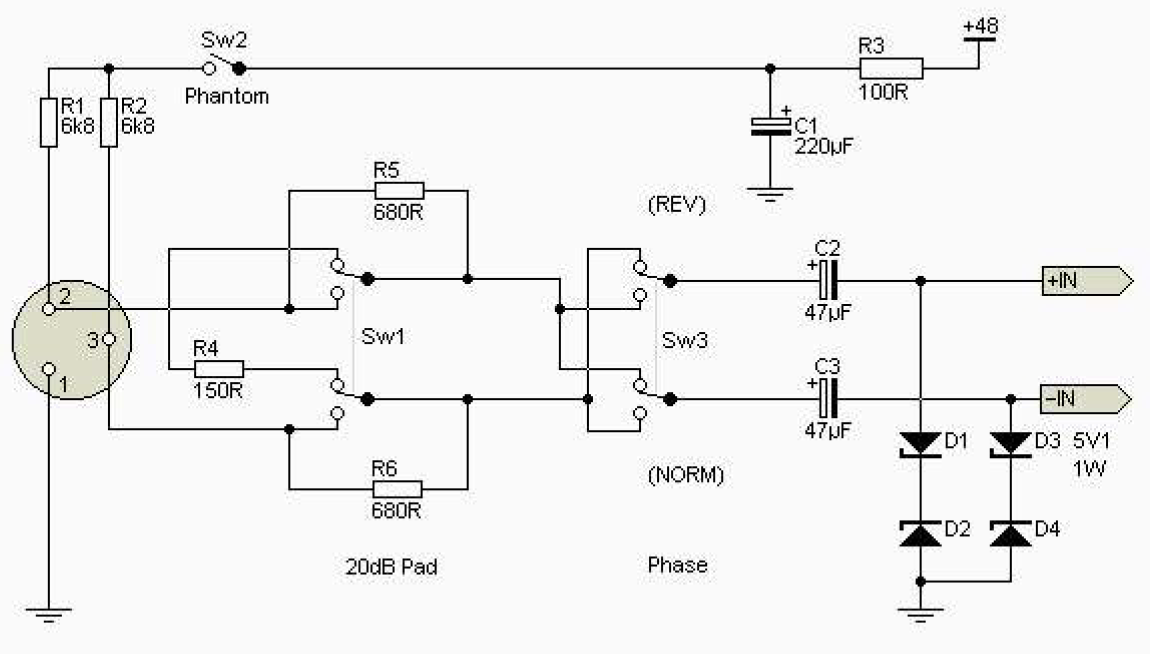
[picture p25: figure]

### 4.4.4 Cálculo

Primero, consideramos la entrada:

| Z_i ≫Z_s →Z_i ≈10 Z_s | (45)

Las resistencias R_(i1) y R_(i2) son las responsables de determinar la impedancia de entrada, por lo que serán de un valor elevado comparado a la impedancia de señal, pero, deben mantenerse en valores lo más chicos posibles. Es la relación de compromiso entre disminuir efectos de carga y mantener bajo ruido. Una buena práctica es:

| R_(i1) +R_(i2) =10 Z_s | (46)

Por lo tanto:

| R_(i1) +R_(i2) =10 . 150Ω=1.5kΩ | (47)

Si R_(i1) =R_(i2) =R_i

| R_i =750Ω→820Ω | (48)

Aproximando a un valor comercial cercano, se obtiene un valor de 820Ω.

Para el cálculo de ganancia, tomamos el peor caso (el valor más bajo posible de la señal de entrada) y la máxima tensión que deseamos a la salida, partiendo que lo recomendado es una ganancia mínima de 10dB ( A≈3 ) para evitar ruido. Como la etapa siguiente es el preamplificador de instrumento, podemos aprovechar dicho circuito para control de ganancia, por lo tanto, llevamos la señal desde un nivel de micrófono a un nivel de instrumento. Determinamos entonces las señales de entrada y salida:

| v_s = -60dBu→v_s =775µV→ v_(s_p) =1.096 mV | (49)
| v_o = -30dBu→v_o =24.5mV→v_o _p =34.65mV | (50)

Por lo tanto:

| G_(dB) =30 dB→G≈31.6 | (51)

Para un amplificador diferencial tenemos que:

| v_o = -V_1 (R_3)/(R_1)+V_2 (R_4)/(R_2 +R_4) (R_1 +R_3)/(R_1) | (52)

Si tenemos que R_1 =R_2 y R_3 =R_4 :

| v_o =(R_3)/(R_1)(V_2 -V_1 ) | (53)

Sabiendo que en nuestra aplicación V_1 será igual a V_2 desfasada en 180º, podemos decir que V_1 =-V_2 ,

| v_o =(R_3)/(R_2)2v_i →(v_o)/(v_i)=(2R_3)/(R_2) | (54)
| G= (2R_f)/(R_i) | (55)

Es decir,

| R_f =(G*R_i)/2=(31.6*820Ω)/2 ≈12.96kΩ→12kΩ | (56)

Elegimos el valor comercial que introduzca menor error, 12kΩ

Respecto a la elección del op amp, se elige el LF357 por sus características electrónicas.

### 4.4.5 Respuesta en frecuencia

Realizamos lo cálculos de los capacitores para que el ancho de banda del preamplificador sea desde 20 Hz hasta 20 kHz.

Para el capacitor de acople:

| f_c =1/(2πRC)→C=1/(2πRf_c) | (57)
| C_1 =C_2 =1/(2π*820Ω*20Hz)≈9.7μF→ 10μF | (58)

Estos capacitores filtran las frecuencias por debajo de 20 Hz. También asignaremos este valor al capacitor de acople a la siguiente etapa. Para filtrar las frecuencias superiores a 20 kHz añadimos un capacitor en paralelo a la resistencia de realimentación, cuyo valor es:

| C_f =1/(2π*12kΩ*20kHz)≈663pF→680pF | (59)

### 4.4.6 Simulación

A continuación, se presenta los resultados de simulación.

Figura 4.4.4

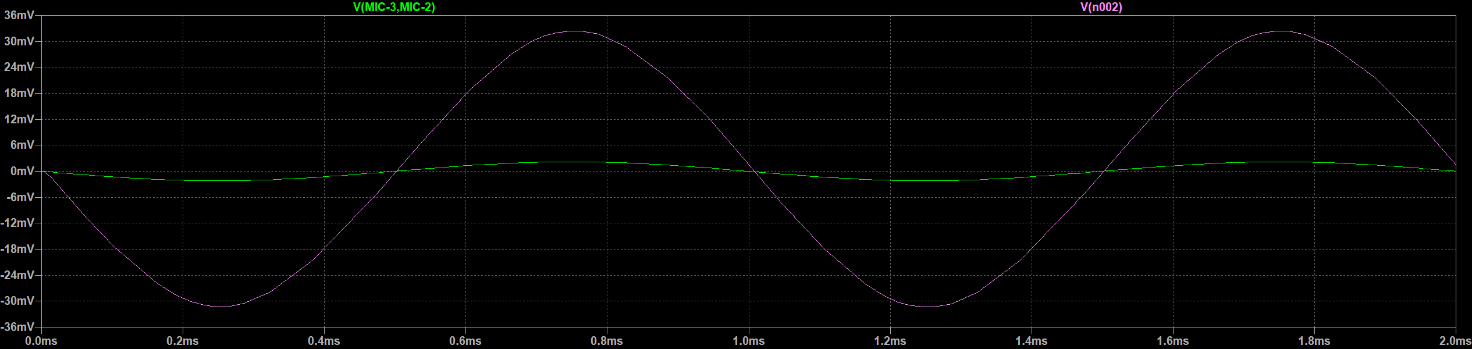
[picture p26: figure]

Para MIC_1 =MIC_2 =MIC_3 =1.096 mV_p , MIC_2 ø=180º se obtuvo V_o =32.43 mV_p , con error relativo ε_(%) =(32.43mV-34.65mV)/(34.65mV)×100≈-6.41% .

Figura 4.4.5

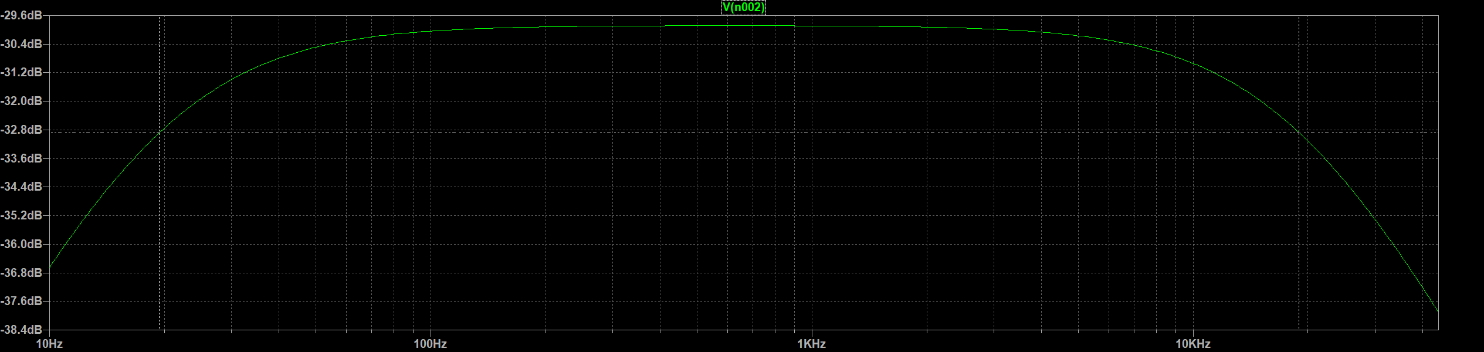
[picture p27: figure]

BW=f_2 -f_1 =18.94kHz-19.42Hz , ε_(%_(20Hz)) ≈-2.9% , ε_(%_(20kHz)) ≈-5.3%

### 4.4.7 Resumen de la etapa

Figura 4.4.6: Esquemático resultante

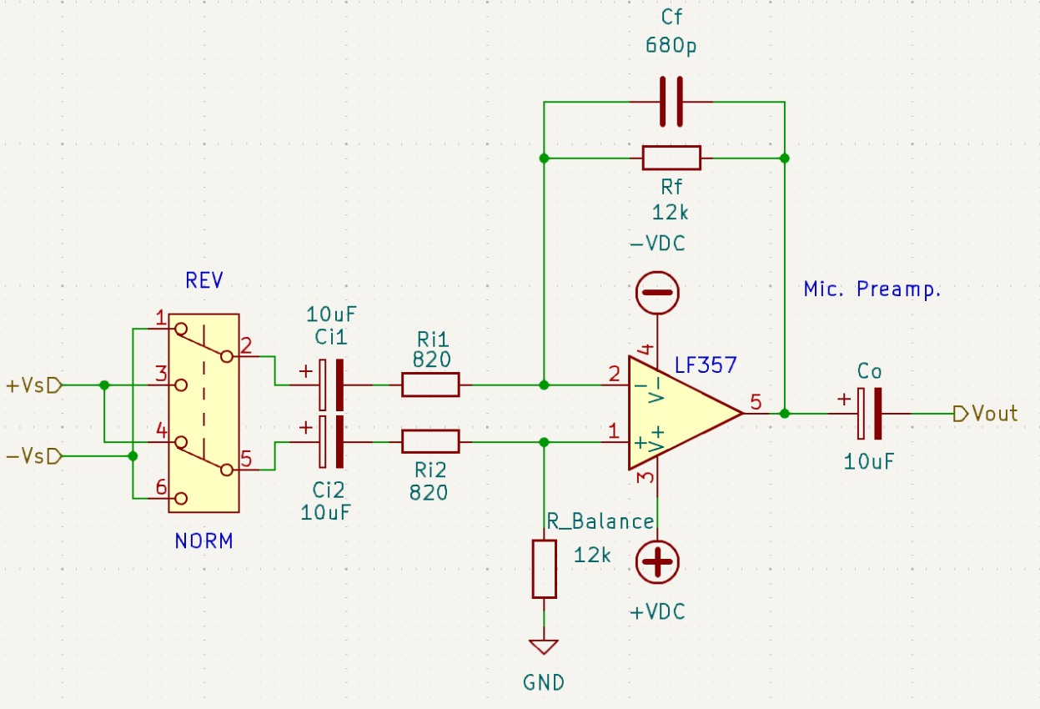
[picture p28: figure]

Tabla 4: Componentes de la etapa

Componente | Valor | Número de Ecuación
R_(i1) , R_(i2) | 820 Ω | (48)
R_f , R_(Balance) | 12 kΩ | (56)
C_(i1) , C_(i2) , C_o | 10 µF | (58)
C_f | 680 pF | (59)

## 4.5 Control de Tonos

El control de tonos es una etapa donde buscamos dividir el ancho de banda del canal en tres principales bandas: Altos, medios y bajos. El diseño fue extraído de un libro (1980 National Semiconductor Corp., 1980), ya que el ajuste de esta etapa se realiza por medio de experimentación. Las curvas de la Figura 4.5.2 muestran el resultado obtenido.

### 4.5.1 Especificaciones

Controlar de manera independiente tres bandas de frecuencia en cada canal.

### 4.5.2 Esquemático

Figura 4.5.1: Circuito control de tonos

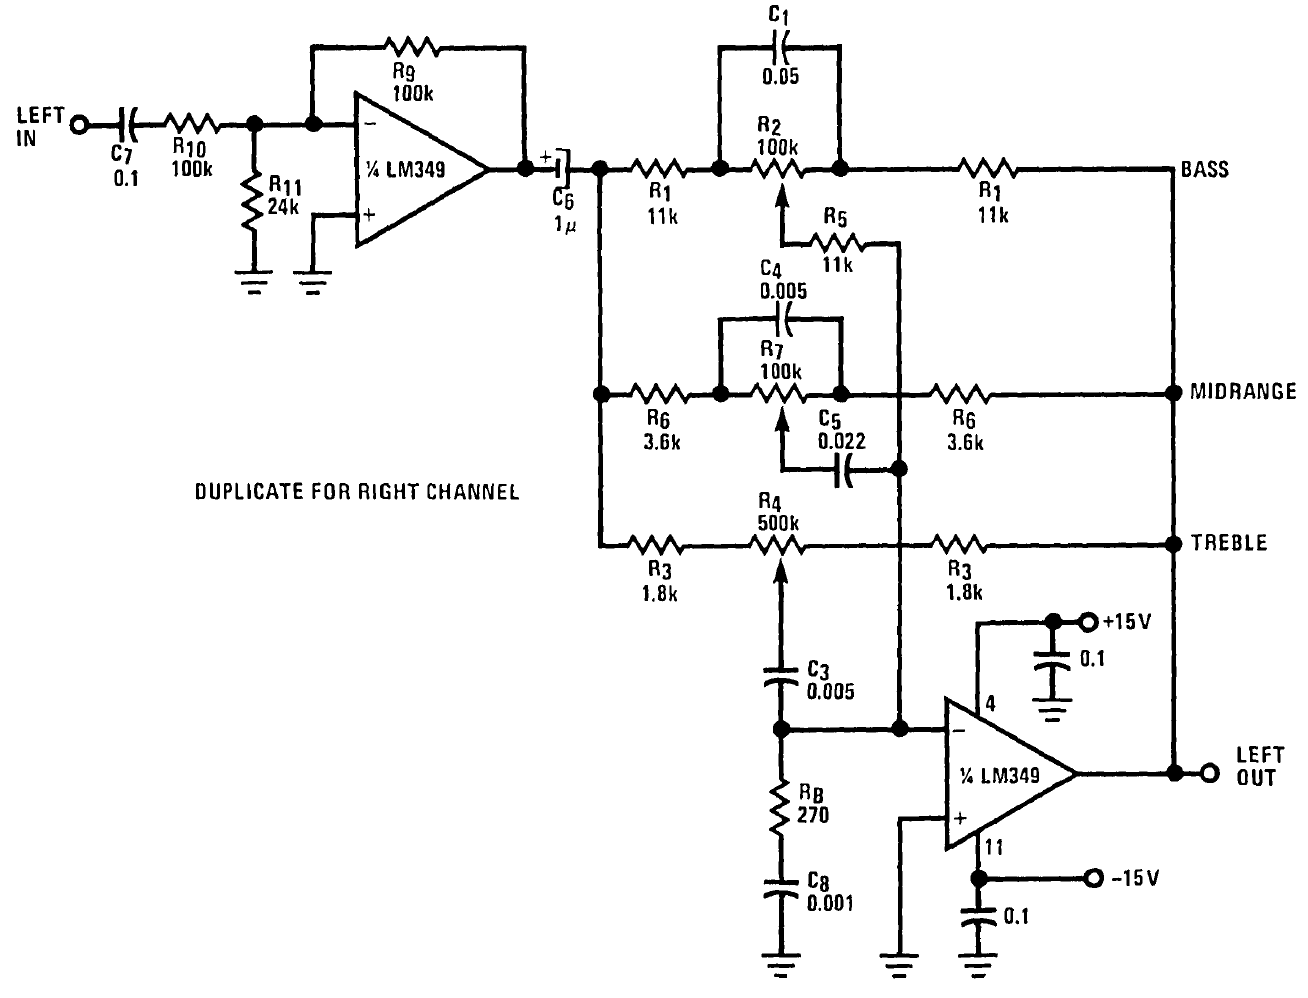
[picture p29: figure]

### 4.5.3 Respuesta en frecuencia

Respuesta prometida en la fuente del circuito es:

Figura 4.5.2: Respuesta en frecuencia

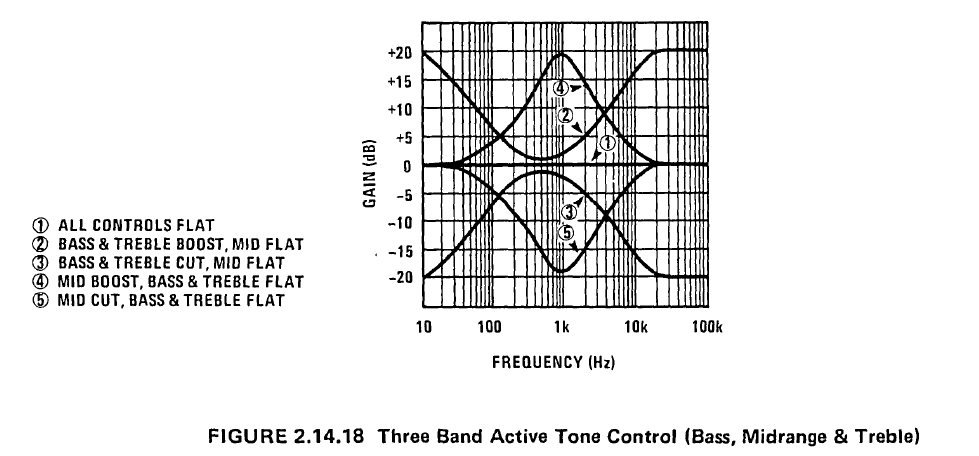
[picture p30: figure]

### 4.5.4 Simulación

Para simular la respuesta en frecuencia, utilizaremos un rango de 10 Hz hasta 25kHz con amplitud de 1V para que la escala plana sea a 0 dB.

Figura 4.5.3: Bajos

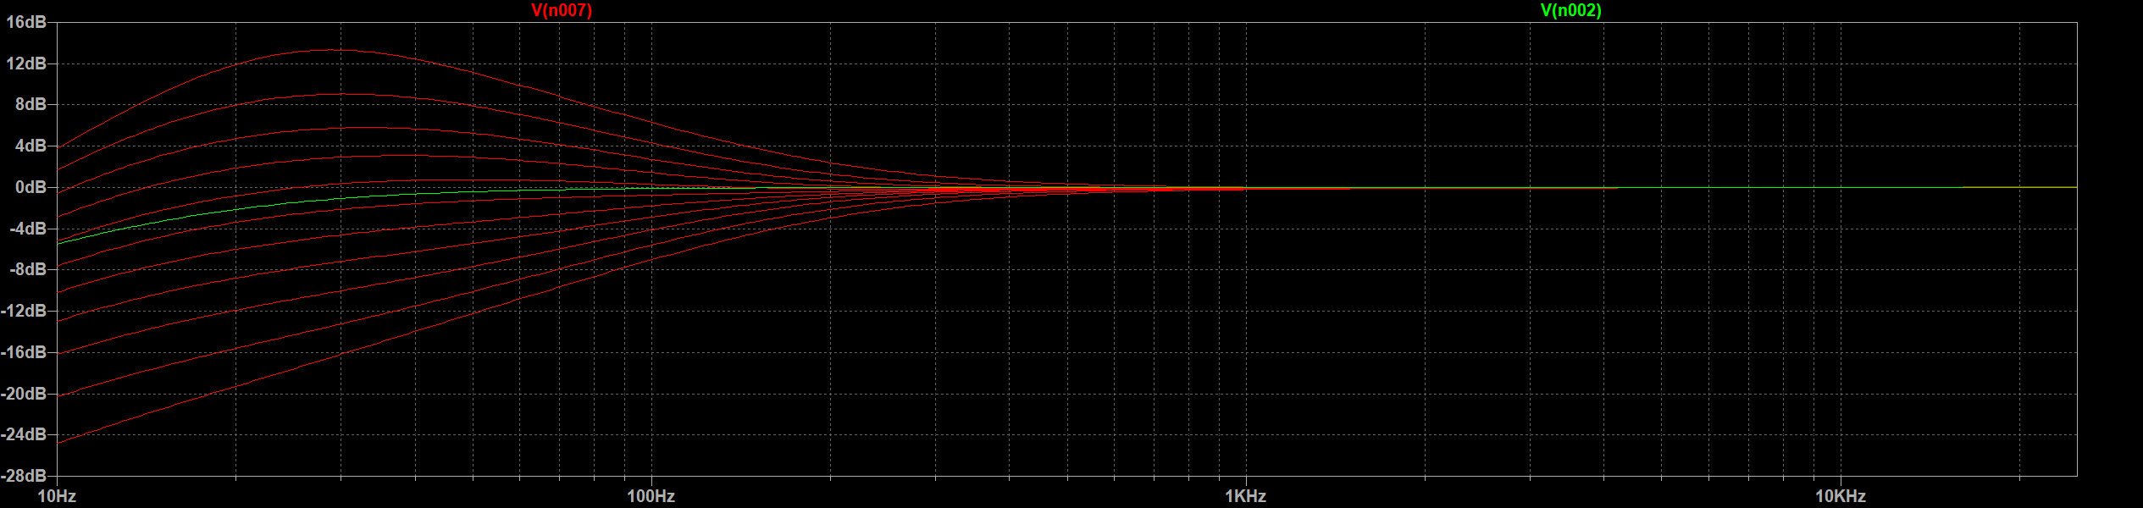
[picture p31: figure]

Figura 4.5.4: Medios

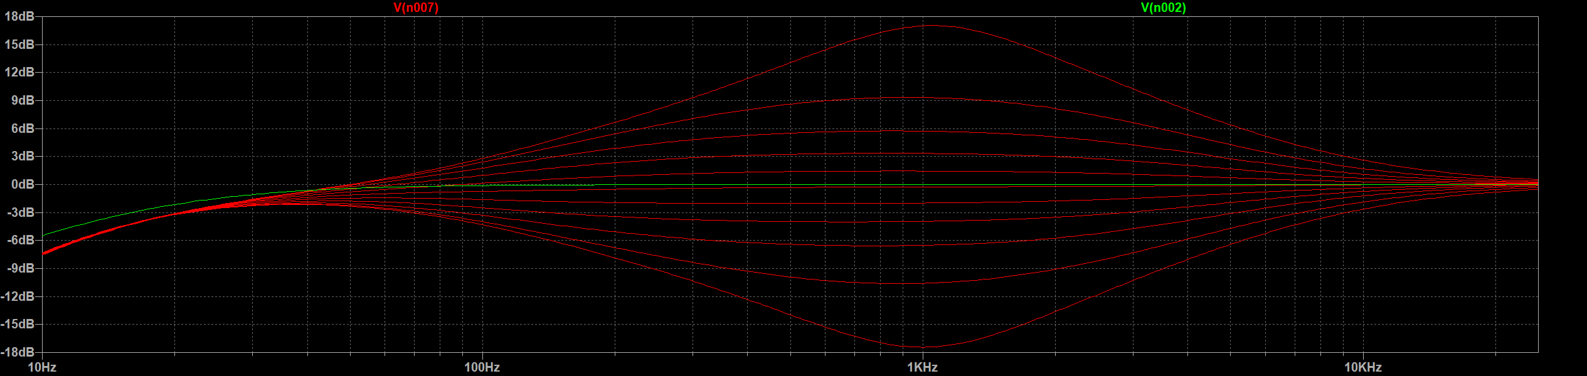
[picture p32: figure]

Figura 4.5.5: Altos

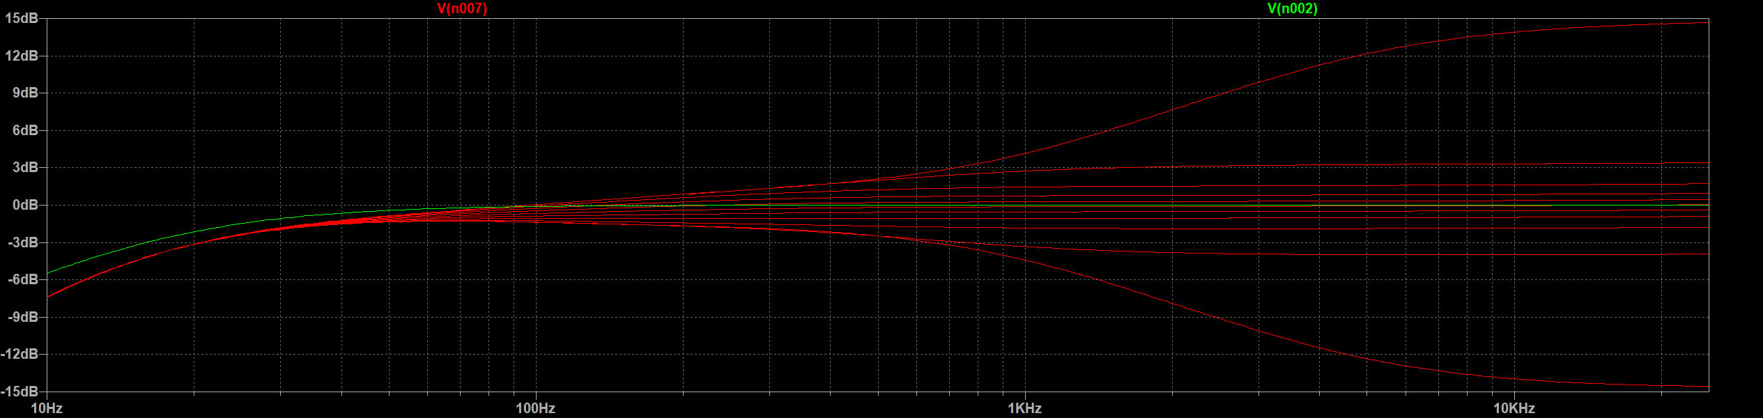
[picture p33: figure]

Finalmente, todas las combinaciones posibles, indican una buena flexibilidad en el control de tonos:

Figura 4.5.6: Combinaciones posibles

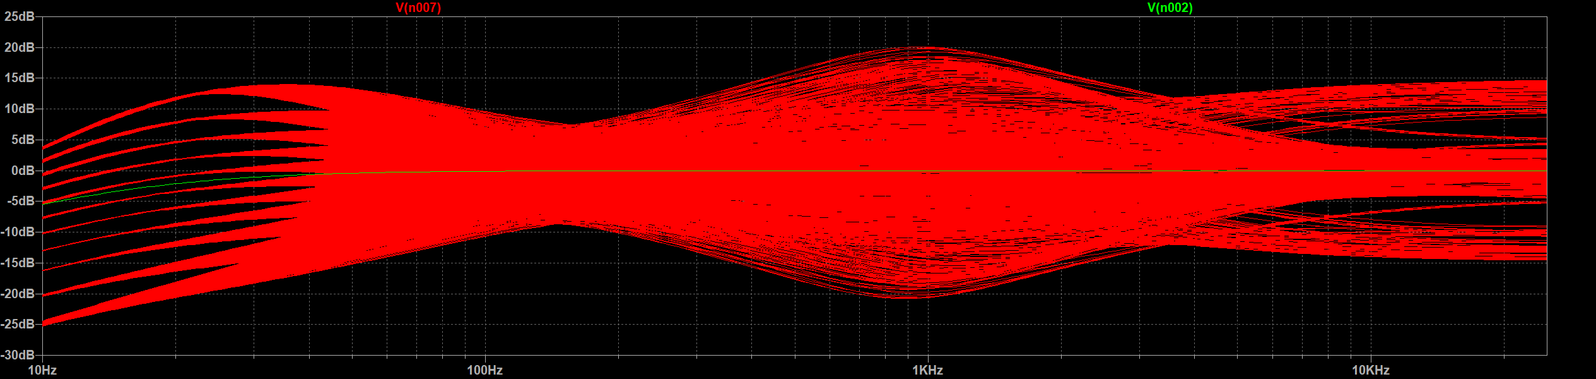
[picture p34: figure]

### 4.5.5 Resumen de la etapa

Figura 4.5.7: Esquemático resultante

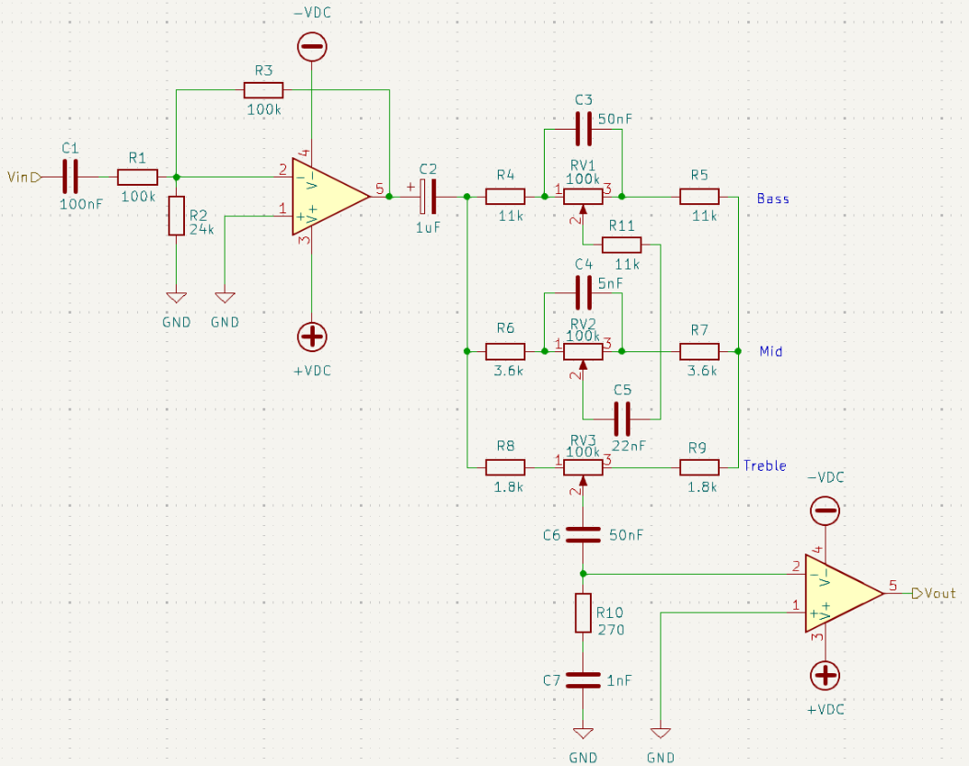
[picture p35: figure]

Tabla 5: Componentes de la etapa

Componente | Valor | Número de Ecuación
R_1 , R_3 , RV_1 , RV_2 , RV_3 | 100 kΩ
R_2 | 24 kΩ
R_4 , R_5 , R_11 | 11 kΩ
R_6 , R_7 | 3.6 kΩ
R_8 , R_9 | 1.8 kΩ
R_10 | 270 Ω
C_1 | 100 nF
C_2 | 1 µF
C_3 , C_6 | 50 nF
C_4 | 5 nF
C_5 | 22 nF
C_7 | 1 nF

## 4.6 Atenuador (Fader)

### 4.6.1 Especificaciones

El atenuador, como su nombre lo indica, tiene como función principal atenuar la señal. Este funciona como un control de volumen del canal. Utilizando un potenciómetro deslizable, cuando la perilla se encuentre en el extremo inferior, no debe haber señal, implicando entonces una ganancia de -∞. También, las consolas que incluyen un “Fader” no solo atenúan, sino que incluso tienen una pequeña ganancia o “boost”. Esto se logra cuando la resistencia variable, es la entrada del circuito.

### 4.6.2 Esquemático

Figura 4.6.1: Atenuador

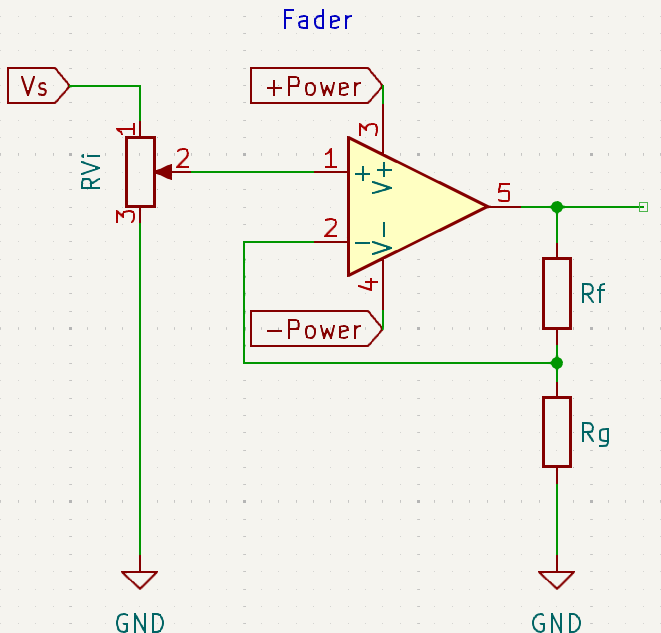
[picture p36: figure]

### 4.6.3 Observaciones

Aprovechamos la alta impedancia que tiene un op amp en configuración de no inversor, para obtener la máxima transferencia de tensión. Como factor negativo, tenemos que, con esta configuración, nunca lograríamos atenuación, como se representa en esta ecuación:

A_v =1+(R_f)/(R_g)

Esto implica, que podemos colocar una resistencia variable a la entrada, de esta forma, se logrará un circuito controlador de volumen.

### 4.6.4 Cálculo

Podemos establecer el valor del potenciómetro deslizable R_(Vi) con criterio basado en su disponibilidad comercial y un valor relativamente bajo para evitar introducir ruido térmico. Además, aplicando el mismo criterio, podemos seleccionar las resistencias R_f y R_g de tal forma que la impedancia de salida sea bastante baja.

| R_(Vi) =10kΩ | (60)
| R_f =R_g =820Ω | (61)

De esta forma, se consigue que la ganancia sea unitaria, pero se logre modificar la amplitud de la señal, de forma que estamos controlando volumen:

| 0V≤v_o ≤2v_i | (62)

### 4.6.5 Respuesta en frecuencia

### 4.6.6 Simulación

Realizamos en la simulación con v_i =0.307V_(RMS) y a variación del potenciómetro desde el 0% hasta el 100%, obteniendo así, todos los posibles valores:

Figura 4.6.2: Respuesta en el tiempo del atenuador

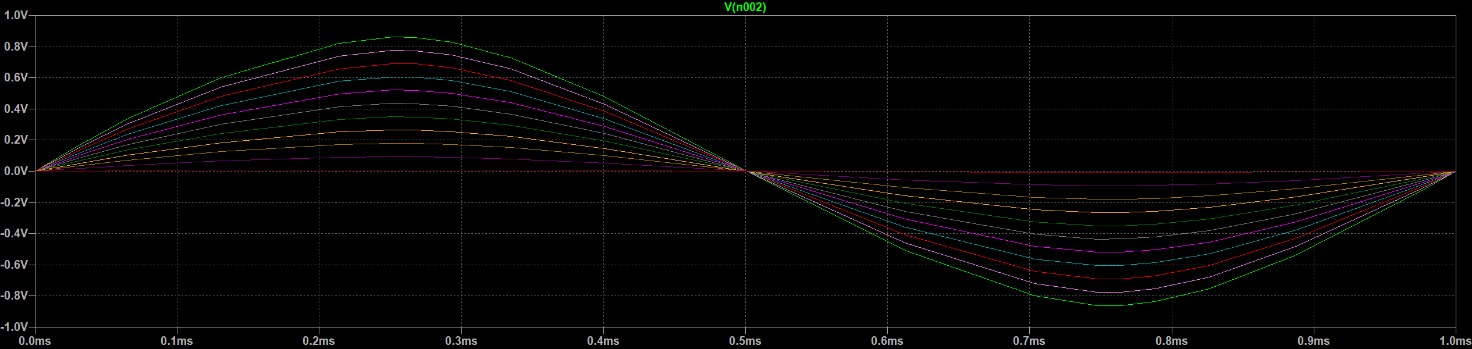
[picture p37: figure]

La mayor amplitud ( 2v_i ) se logra cuando el potenciómetro se encuentra al 0%, y la menor amplitud (0V) cuando se encuentra al 100%.

Figura 4.6.3: Respuesta en frecuencia del atenuador

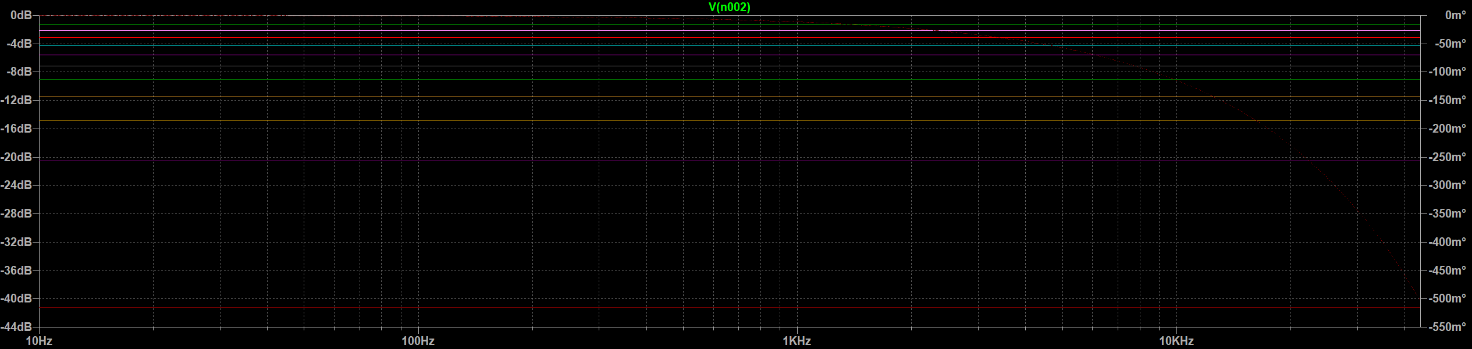
[picture p38: figure]

Vemos un comportamiento “flat” (plano) de la amplitud para todas las frecuencias.

### 4.6.7 Resumen de la etapa

Figura 4.6.4: Esquemático resultante

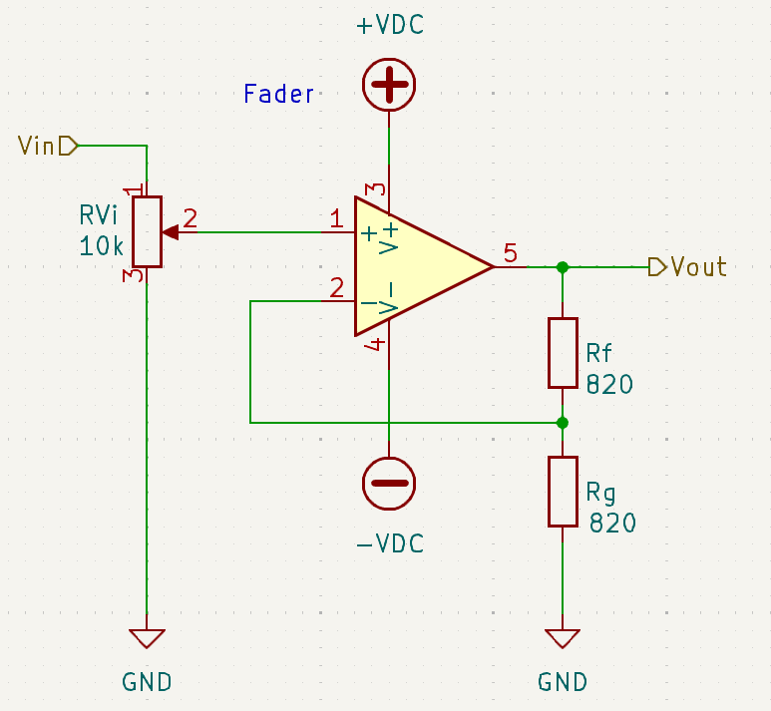
[picture p39: figure]

Tabla 6: Componentes de la etapa

Componente | Valor | Número de Ecuación
RV_i | 10 kΩ | (60)
R_f , R_g | 820 Ω | (61)

## 4.7 Adicionales

### 4.7.1 Detector de picos

Es un indiciador para asegurar que la señal no se encuentre recortada (anti-clipping). Utilizamos un detector de picos de doble polaridad para detectar recortes tanto en el hemiciclo positivo como en el negativo.

Figura 4.7.1: Detector de picos

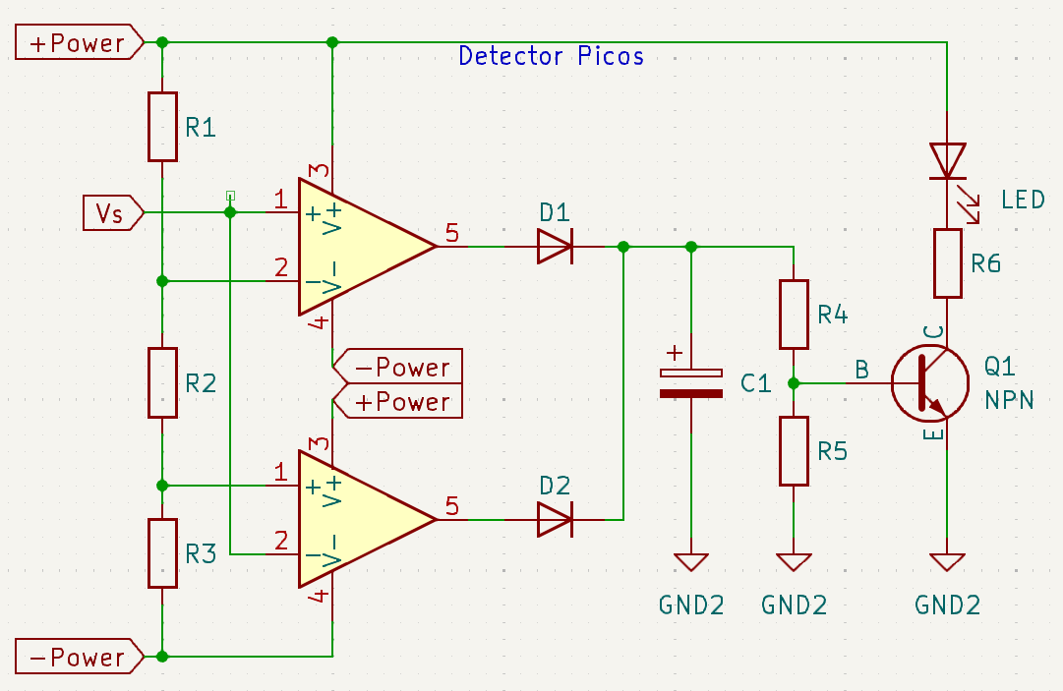
[picture p40: figure]

Para este diseño, los op amps son utilizados como comparadores. Las resistencias R1, R2 y R3 determinan el valor límite (threshold). Si R1 y R3 son iguales, el límite se ajusta directamente con R2. El capacitor C1 varía la capacidad del circuito para detectar transitorios cortos. Un valor de capacitancia alto detecta mayor cantidad de transitorios cortos, pero disminuye el tiempo del LED para indicar el pico.

La señal de entrada de esta etapa es la salida del control de tonos. Podemos entonces determinar el valor límite donde detectamos un pico:

| V_(threshold_p) =1.75 V | (63)

Sabemos además que para el comparador positivo:

| V_(threshold) =(R_2)/(R_1 +R_2)×V_(supply) | (64)

Operando, encontramos la relación:

| R_2 ≈0.132R_1 | (65)

Elegimos un valor para R_1 :

| R_1 =10kΩ | (66)
| R_2 ≈1.32kΩ→R_2 =1.2kΩ | (67)

No podemos elegir un valor comercial para R_2 superior al calculado, ya que elevaríamos del límite el valor “threshold”. Análogamente para el comparador negativo:

| R_3 =R_1 =10kΩ | (68)

Por simplicidad podemos seleccionar:

| R_5 =0.1R_4 | (69)
| R_4 =10kΩ | (70)
| R_5 =1kΩ | (71)

Y finalmente, R_6 controla la corriente de LED. Para excitar al mismo necesitamos una corriente de aproximadamente 20 mA, por lo que:

| R_6 =(V_(supply) -V_(LED) -V_(CE(sat)))/(I_(LED))≈(15V-2V-0.2V)/(0.02A)≈140Ω→150Ω | (72)

Se presenta a continuación el circuito final:

Figura 4.7.2: Esquemático resultante

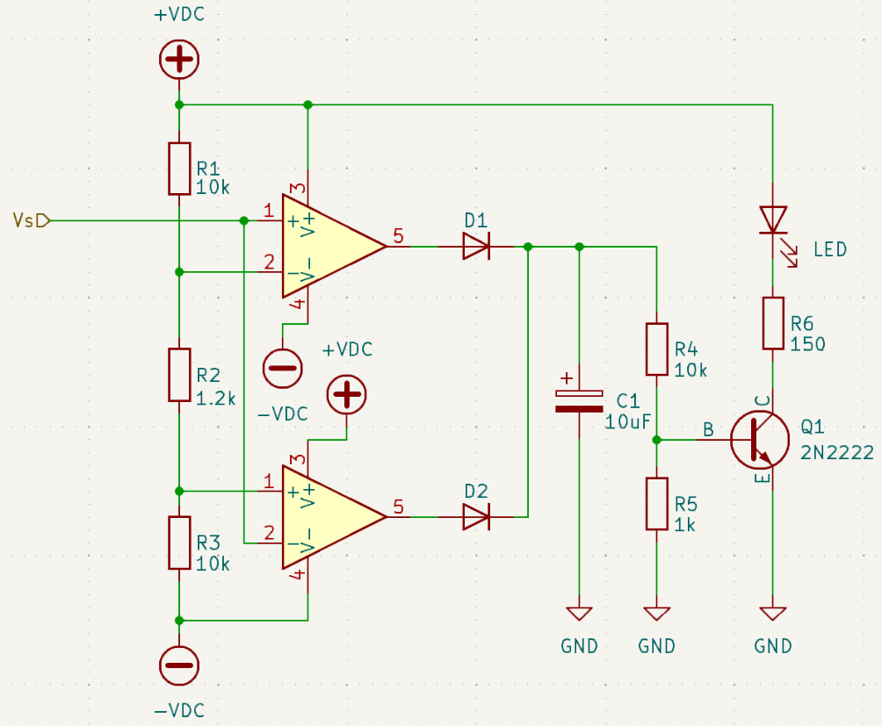
[picture p41: figure]

Tabla 7: Componentes de la etapa

Componente | Valor | Número de Ecuación
R_1 , R_3 , R_4 | 10 kΩ | (66)(68)(70)
R_2 | 1.2 kΩ | (67)
R_5 | 1 kΩ | (71)
R_6 | 150 Ω | (72)
C_1 | 10 µF

### 4.7.2 Amplificador para auriculares

Se evalúa la posibilidad de usar un op amp de potencia como el LM1875 por simplicidad de diseño además los auriculares no requieren de una muy alta corriente. Nos basaremos en el diseño de (Elliott, 1999).

Figura 4.7.3: Amplificador para auriculares

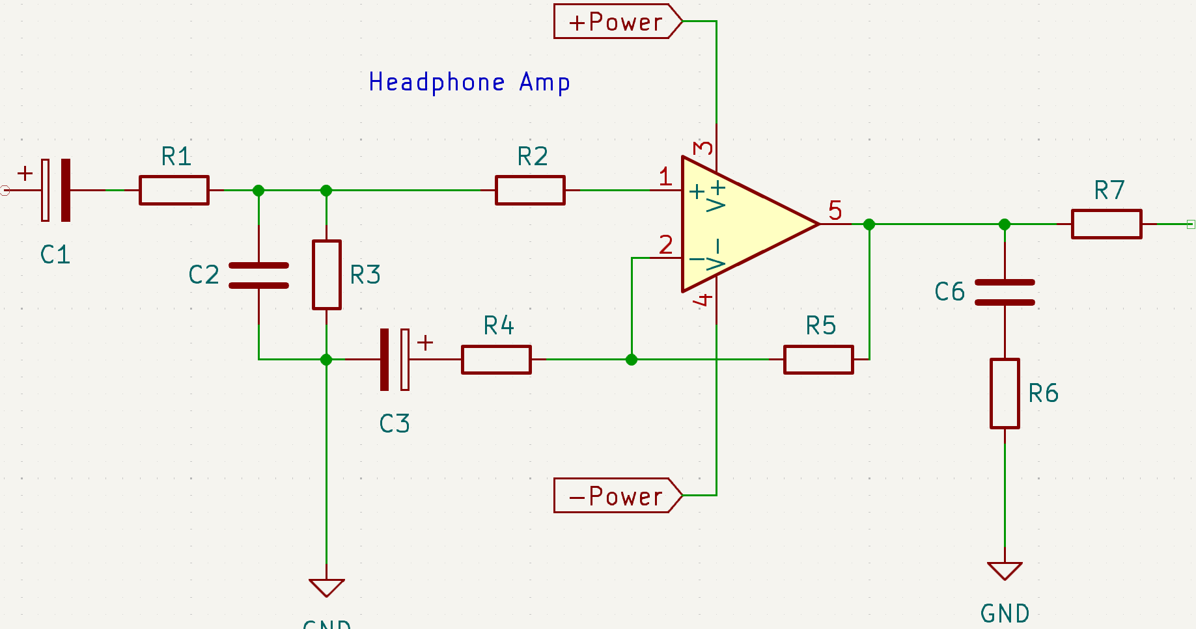
[picture p42: figure]
A diagram of a circuit

Modificar el valor de R7 permite ajustar el nivel de señal según los requerimientos. Si se necesita aumentar el nivel de señal, debemos reducir el valor de esta resistencia.

A la salida de cada control de tonos tendremos valores de tensión en nivel de línea, debido a que estamos trabajando luego del preamplificador.

Las resistencias R1, R3 y R4 junto con los capacitores C1, C2 y C3, sirven para los ajustes de la respuesta en frecuencia. Además, R4 y R5 son los que cierran el lazo de realimentación. Si observamos, R6 y C6 cumplen la función de red de Zobel.

El resultado final es el siguiente:

Figura 4.7.4: Esquemático resultante

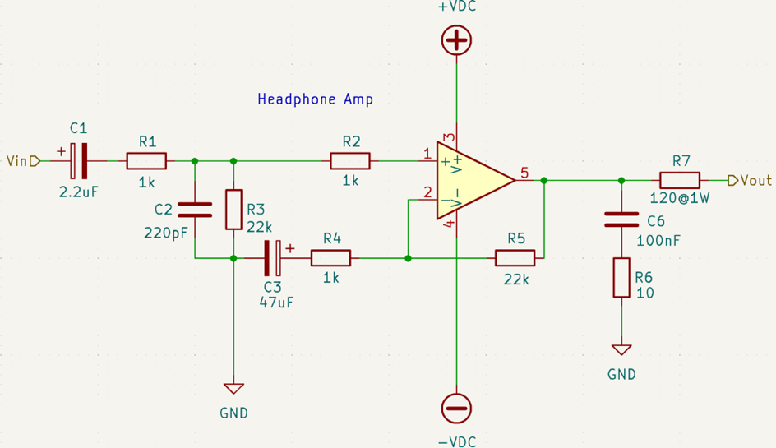
[picture p43: figure]

Tabla 8: Componentes de la etapa

Componente | Valor | Número de Ecuación
R_1 , R_2 , R_4 | 1 kΩ
R_3 , R_5 | 22 kΩ
R_6 | 10 Ω
R_7 | 120 Ω @ 1 W
C_1 | 2.2 µF
C_2 | 220 pF
C_3 | 47 µF
C_6 | 100 nF

### 4.7.3 VU Meter

El IC LM3914, utiliza op amps como comparadores. Típicamente la tensión de referencia para estos integrados es 1.25 V, además, su corriente suele ser de 1 mA. Teniendo en cuenta estos datos, podemos obtener los siguientes valores de resistencias:

| R=(1.25V)/(1mA)=1.25kΩ→1.2kΩ | (73)
| RV_(preset) =10kΩ | (74)
| R_(led) =(V_(supply) -V_(LED))/(I_(LED))=(15V-2V)/(0.02A)=650Ω→680Ω | (75)

El resultado final es el siguiente:

Figura 4.7.5: VU Meter con IC LM3914N

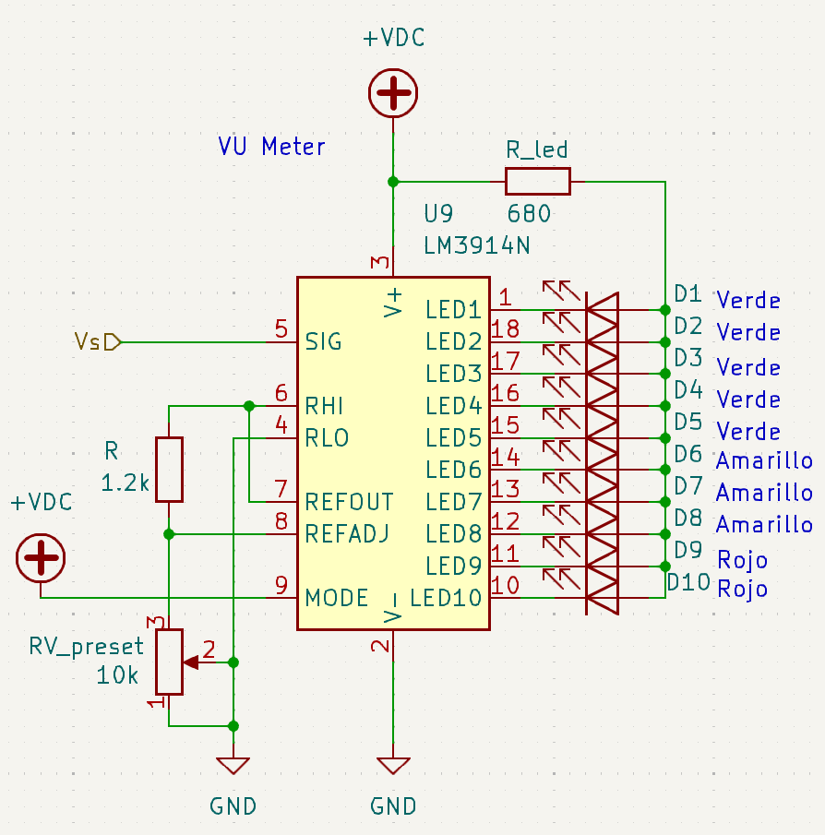
[picture p44: figure]

Tabla 9: Componentes de la etapa

Componente | Valor | Número de Ecuación
R | 1.2 kΩ | (73)
RV_(preset) | 10 kΩ | (74)
R_(led) | 680 Ω | (75)

# 5 Fuente de alimentación regulada

## 5.1 Rectificación y Filtrado

### 5.1.1 Especificaciones

La fuente de alimentación debe ser capaz de suministrar a cada circuito. El dato que se dispone de ante mano, es que debe suministrar una tensión de ±15V , con un punto común como GND. Se deberá calcular la corriente.

En esta etapa, nos encargaremos de rectificar y filtrar la tensión de línea. Se considera que la misma es una senoidal pura de 50Hz con amplitud 220V_(RMS) .

### 5.1.2 Esquemático

Figura 5.1.1: Etapa rectificadora

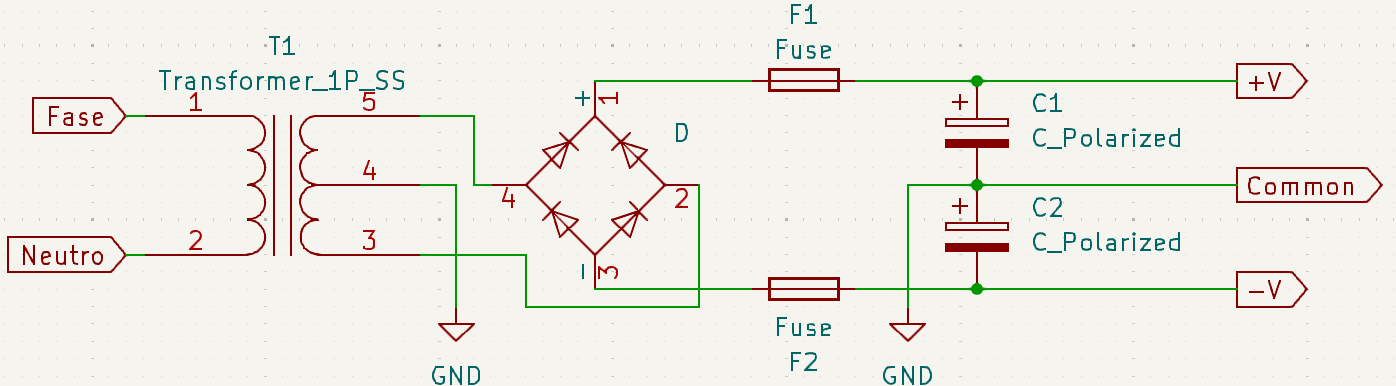
[picture p45: figure]

### 5.1.3 Cálculo

Para determinar los componentes necesarios, requerimos conocer la corriente que debe suministrar la fuente. Por lo tanto, debemos sumar las corrientes de cada etapa.

En el caso de los op amp, se debe tener en cuenta que la corriente que consume es:

| , I_(tot) =I_(quiscent) +I_o +I_f | (76)

donde I_(quiscent) que es la corriente de reposo que se expresa en las hojas de datos, I_o es la corriente de salida del operacional, e I_f es la corriente que circula por la red de realimentación.

Promediamos la corriente de reposo para cada op amp en 100µA. En nuestro proyecto, contamos con 10 amplificadores operacionales, por lo tanto:

| I_(quiscent) ≈1mA | (77)

Luego, analizamos para cada circuito su consumo. Para el amplificador de potencia, nos basamos en las ecuaciones (3) y (8):

| I_(etapa potencia) =I_(Bias) +I_L =1.24mA+0.61A≈0.61 A | (78)

En la etapa del sumador tenemos:

| , I_o =1mA | (79)
| I_f ≈370μA | (80)
| , I_(sumador) ≈1.37mA | (81)

Y en cada canal observamos los siguientes consumos:

| , I_(MIC) +I_(Line) +I_(Preamp) +I_(toneCtrl) +I_(fader) +I_(peakDet) +I_(headphones) | (82)

La corriente de canal se debe multiplicar por 4, ya que son 4 canales:

| , I_(canales) =4I_(canal) | (83)
| , I_(canales) ≈38.36mA | (84)

En total tendremos:

| , I_(tot) =I_(power-amp) +I_(sumador) +I_(canales) | (85)
| , I_(tot) ≈0.65A | (86)

Podemos realizar una aproximación a:

| , I_(tot) =1A | (87)

Los capacitores determinan el rizado (o “ripple”), lo deseable sería que estos, tengan una gran capacidad, para reducir dicho efecto, aunque esto no es recomendable ya que las corrientes que circulan por los diodos son de corta duración y grandes picos de corriente. Por lo tanto, entramos en esta relación de compromiso. Al tratarse de una aplicación de audio, queremos un rizado máximo de 1V, para evitar distorsión de señal.

Para obtener a la salida del regulador, una tensión de +15V y -15V, deberemos proporcionarle una tensión mínima de aproximadamente +20V y -20V respectivamente desde el transformador. Con este margen, consideramos la tensión de rizado, caídas de tensión de los diodos y además la caída de tensión que se puede producir en el circuito del regulador. Además de las tolerancias de los componentes.

Calculamos entonces la tensión del bobinado será:

| V_(trafo) =(20V)/(√2)≈14.14V | (88)

Nuestro transformador entonces tendrá que ser de 220V a 15+15 V con punto medio. O utilizar dos transformadores de 220V a 15V.

Calculamos los capacitores:

| , C_1 =C_2 =I/(2f_(RED) V_(v_(pp))) | (89)

La tensión de rizado se calcula como:

| , V_(v_(pp)) =V_(trafo) -V_D -V_(reg) ≈(15√2-0.8)-18=2.41V | (90)
| , C_1 =C_2 ≈4149.38µF→4700μF | (91)

El valor comercial más cercano será 4700µF.

### 5.1.4 Simulación

Figura 5.1.2: Salida del rectificador en vacío

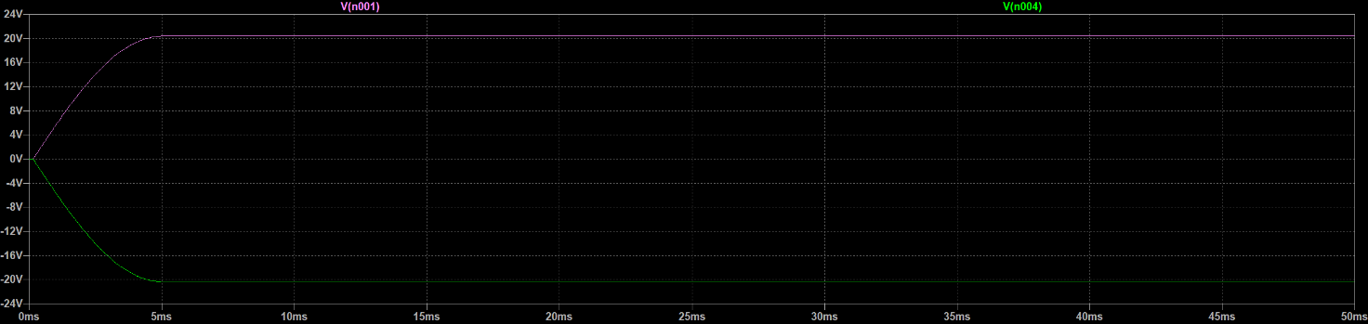
[picture p46: figure]

### 5.1.5 Resumen de la etapa

Figura 5.1.3: VU Meter con IC LM3914N

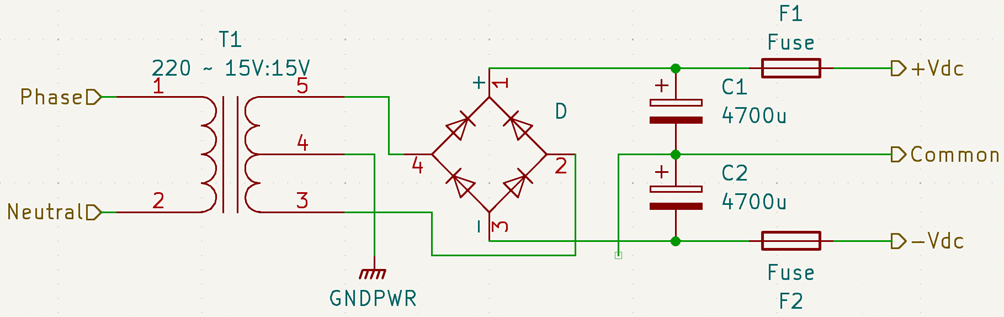
[picture p47: figure]

Tabla 10: Componentes de la etapa

Componente | Valor | Número de Ecuación
C_1 , C_2 | 4700 µF | (91)

## 5.2 Regulador

### 5.2.1 Especificaciones

### 5.2.2 Esquemático

Figura 5.2.1: Etapa reguladora

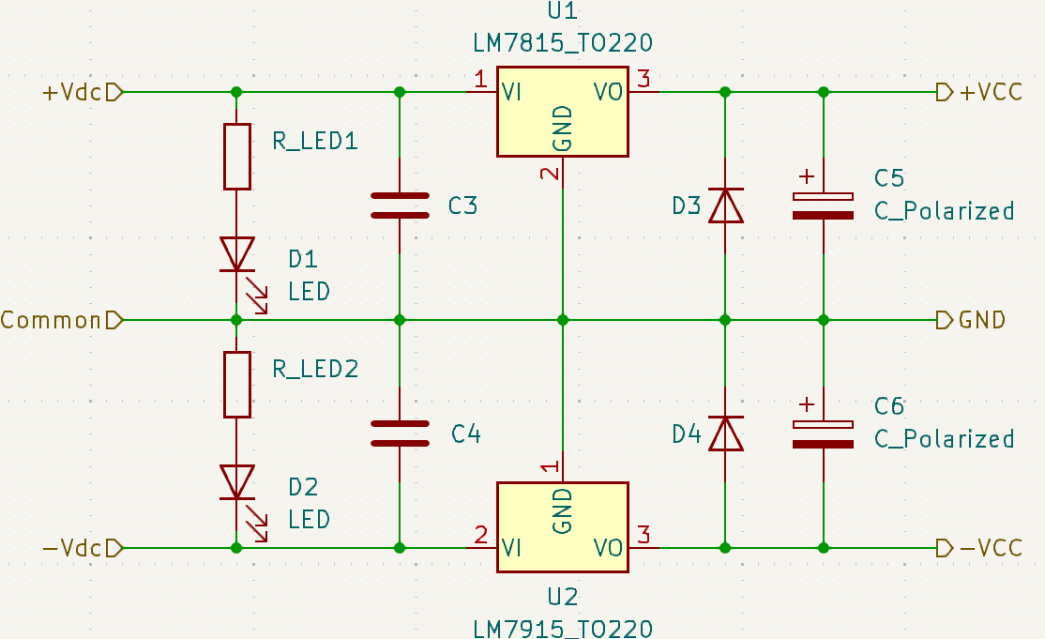
[picture p48: figure]

### 5.2.3 Cálculo

Para las resistencias de led, tenemos:

| , R_(LED) =(19V-2V)/(20mA)≈900Ω→820Ω | (92)

Sabiendo que tenemos que proveer una tensión máxima de ±15V , y conocemos la corriente en la ecuación (87), podemos calcular la resistencia de carga máxima para la simulación:

| R_L =(V_(max))/(I_(max))=(30V)/(1A)=30Ω | (93)

### 5.2.4 Simulación

Figura 5.2.2: Tensiones en cada nodo de R_L

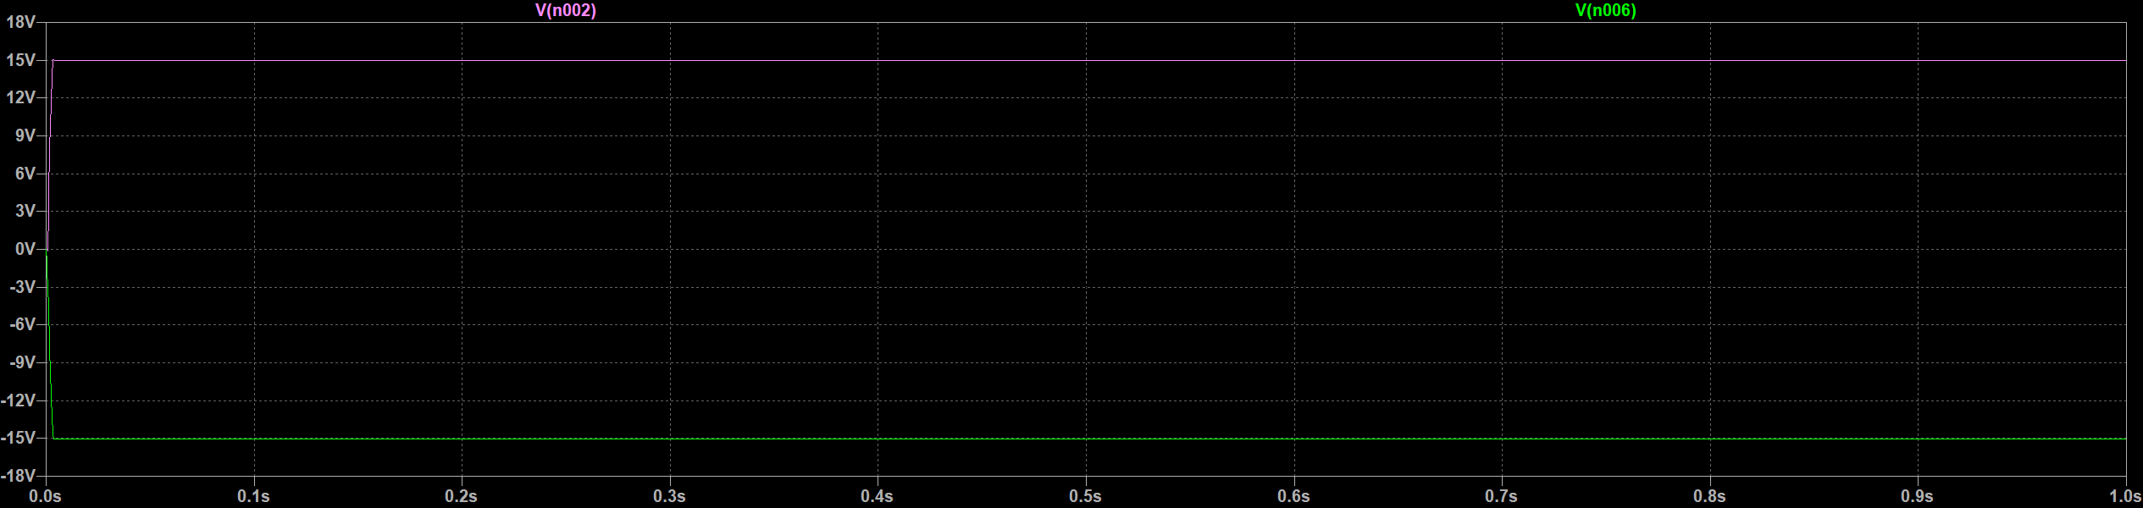
[picture p49: figure]

Figura 5.2.3: Tensión V_(R_L)

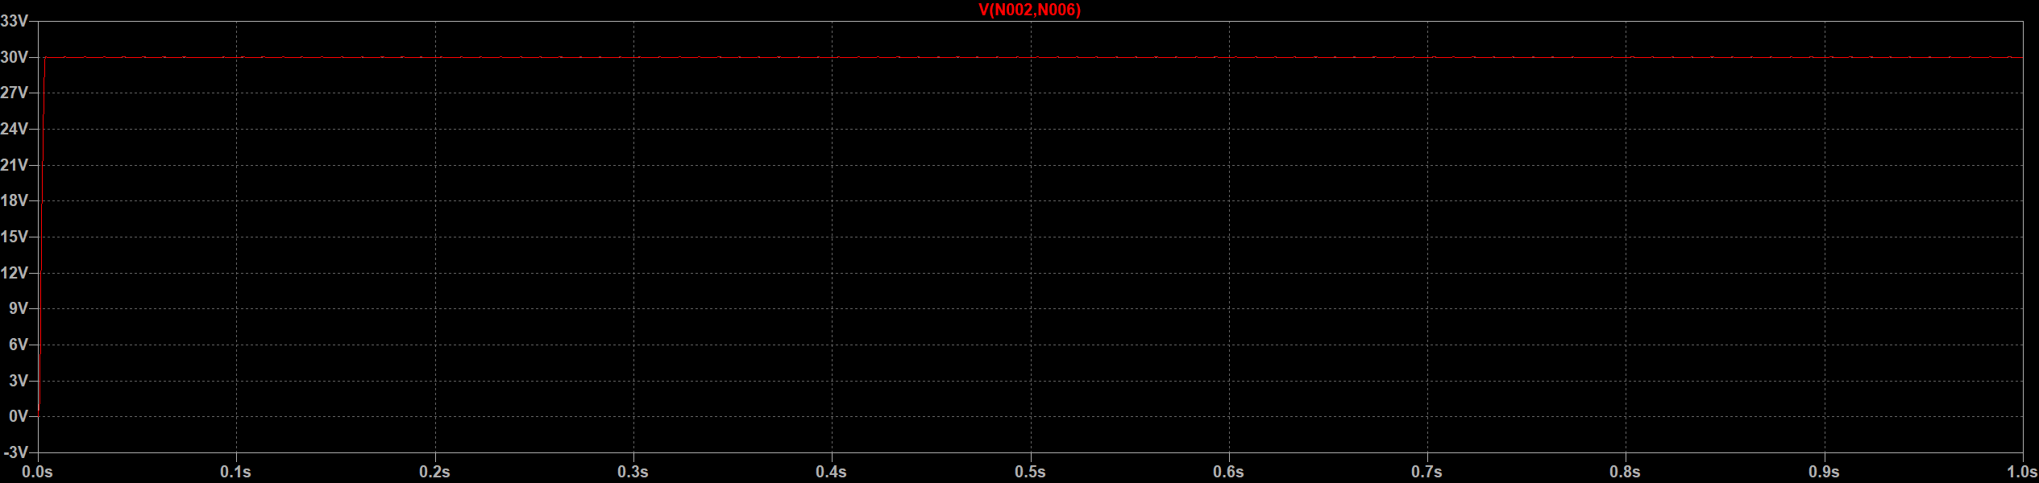
[picture p50: figure]

Figura 5.2.4: Corriente I_(R_L)

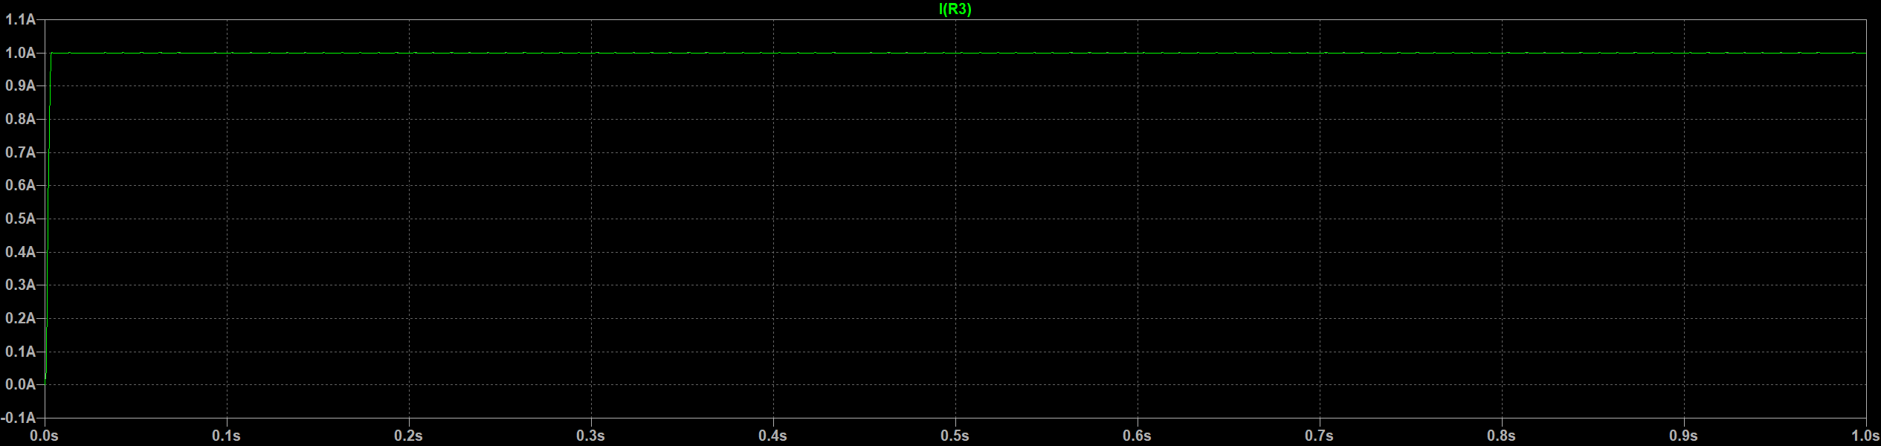
[picture p51: figure]

### 5.2.5 Resumen de la etapa

Figura 5.2.5: Esquemático resultante

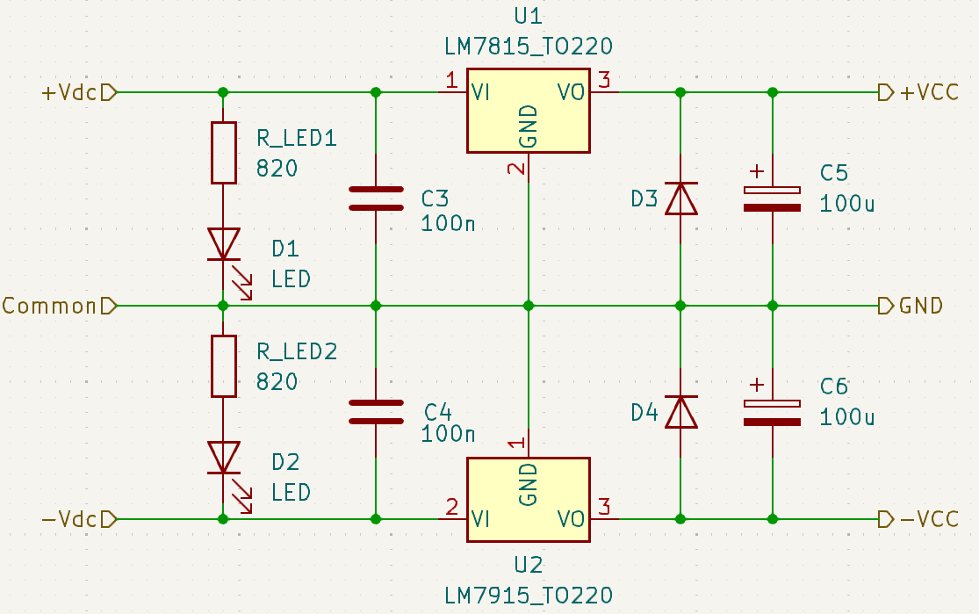
[picture p52: figure]

Tabla 11: Componentes de la etapa

Componente | Valor | Número de Ecuación
R_(LED_1 ,) , R_(LED_2) | 820 Ω | (92)
C_3 , C_4 | 100 nF | (58)
C_5 , C_6 | 100 µF | (59)

# 6 Bibliografía y Referencias

1980 National Semiconductor Corp. (1980). Audio/Radio Handbook.

3 Channel Audio Mixer Circuit. (s.f.). Obtenido de Electro Schematics: https://www.electroschematics.com/3-channel-audio-mixer/

ACADENAS. (25 de Febrero de 2020). Como diseñar fuente de tensión simetrica 12 y -12V con 3A (Clase 91). Obtenido de YouTube: https://www.youtube.com/watch?v=Ts09VScBMrs

ACADENAS. (4 de Noviembre de 2021). How the class B and AB power amplifier (Class 57) works. Obtenido de YouTube: https://youtu.be/iG-Kr2umHbY

Arcortex: electronica. (11 de Noviembre de 2022). Amplificador clase AB - Análisis conceptual. Obtenido de YouTube: https://youtu.be/xcO18-cuovA

Baker, D. (28 de Septiembre de 2020). Controls on a Mixing Desk: An Explanation. Obtenido de YouTube: https://www.youtube.com/watch?v=UWja2PmL1HQ

Behringer XENYX 1622FX User Manual. (s.f.). Obtenido de manualslib: https://www.manualslib.com/manual/454157/Behringer-Xenyx-1622fx.html

BJT Current Source. (2008). Obtenido de eCircuit Center: https://www.ecircuitcenter.com/Circuits_Audio_Amp/BJT%20Current_Source/BJT_Current_Source.htm

Design a class AB audio amplifier. (2020). Obtenido de electronics.stackexchange: https://electronics.stackexchange.com/questions/529475/design-a-class-ab-audio-amplifier

Differences between Mic, Line, and Instrument level. (2024). Obtenido de Focusrite: https://support.focusrite.com/hc/en-gb/articles/115004171025-Differences-between-Mic-Line-and-Instrument-level

Elliott, R. (September de 1999). High Quality Audio Mixer. Obtenido de Elliott Sound Products (ESP): https://sound-au.com/project30.htm

Gupta, S. (14 de Julio de 2020). Audio Equalizer / Tone Control Circuit with Bass, Treble and MID Frequency Control using Op-Amp. Obtenido de circuitdigest: https://circuitdigest.com/electronic-circuits/audio-equalizer-tone-control-circuit-with-bass-treble-and-mid-frequency-control

How to Build an Audio Mixer. (s.f.). Obtenido de Circuit Basics: https://www.circuitbasics.com/what-are-audio-mixers/

Kaul, V. (26 de Mayo de 2021). Line In vs. Mic In (Audio Signals Explained For Dummies). Obtenido de Producer Hive: https://producerhive.com/ask-the-hive/line-in-vs-mic-in/

Mixed Signals. (30 de Julio de 2021). Preamps, Latency, Buffers, Analog to Digital Conversion // Audio Interfaces Part 3. Obtenido de YouTube: https://www.youtube.com/watch?v=6OSLaZVVIFc

Mundo Electrónica. (23 de Agosto de 2022). Aprendiendo desde cero sobre amplificadores clase AB | Teoría, Diseño, Práctica. Obtenido de YouTube: https://youtu.be/lEq_bKRIazQ

Nawazi, F. (5 de August de 2022 ). Audio Mixer Circuit. Obtenido de Circuits-diy: https://www.circuits-diy.com/audio-mixer-circuit/

Non-inverting Operational Amplifier. (s.f.). Obtenido de Electronics Tutorials: https://www.electronics-tutorials.ws/opamp/opamp_3.html

Producer Hive. (12 de Mayo de 2022). Audio Interface vs Preamp vs Mixer (Key Differences You Must Know). Obtenido de Producer Hive: https://producerhive.com/buyer-guides/audio-interfaces/audio-interface-vs-preamp/

Push-Pull Power Amplifier with Darlington and Sziklai Transistor pairs. (13 de Noviembre de 2023). Obtenido de YouTube: https://www.youtube.com/watch?v=866MYibo8yE

Ramirez, F. (17 de Junio de 2017). ¿Como operar una consola de sonido? Obtenido de YouTube: https://www.youtube.com/watch?v=hGGfl6TzgXw

Sonomarcas. (13 de Agosto de 2021). Consola Pasiva de 4 Canales, Con Interface + Reproducción de USB y Bluetooth MFX400 AudioPro. Obtenido de YouTube: https://www.youtube.com/watch?v=j_ktzWkornU

SRT Amplification. (30 de Agosto de 2020). BONUS VIDEO: Balanced Inputs and Op Amps. Obtenido de YouTube: https://www.youtube.com/watch?v=R3Ka8WTCOfQ

The AudioPhool. (25 de Noviembre de 2021). Simple DIY Mixer w/ Op-Amps. Obtenido de YouTube: https://www.youtube.com/watch?v=YCIcnFuRK7w

The Differential Amplifier. (s.f.). Obtenido de Electronics Tutorials: https://www.electronics-tutorials.ws/opamp/opamp_5.html

Wikipedia. (11 de Diciembre de 2023). Nivel de línea. Obtenido de Wikipedia: https://es.wikipedia.org/wiki/Nivel_de_l%C3%ADnea

Xtreme Acoustics. (10 de Enero de 2022). How to Setup your Xtreme Acoustics XAMXB4 Professional 4 Channel Live Audio Mini Mixer. Obtenido de YouTube: https://www.youtube.com/watch?v=H9ldVAt_qsA

Universidad Tecnológica Nacional – Facultad Regional Mendoza Ingeniería electrónica – Electrónica aplicada II – 2025 Anteproyecto para trabajo final de cátedra “Mezclador y Amplificador de 3 W”
