Exequiel25/Mezclador-de-4-canales-y-Amplificador-de-3W/Presentación/Proyecto Final EA2-Magni Genre,Exequiel Juan.pptx

## Mezclador de audio de 4 canales y amplificador de 3W

Trabajo final de cátedra: Electrónica Aplicada 2

Autor: Magni Genre, Exequiel Juan

## Diagrama en bloques general


## Diagrama de un canal


## Diagrama del sumador

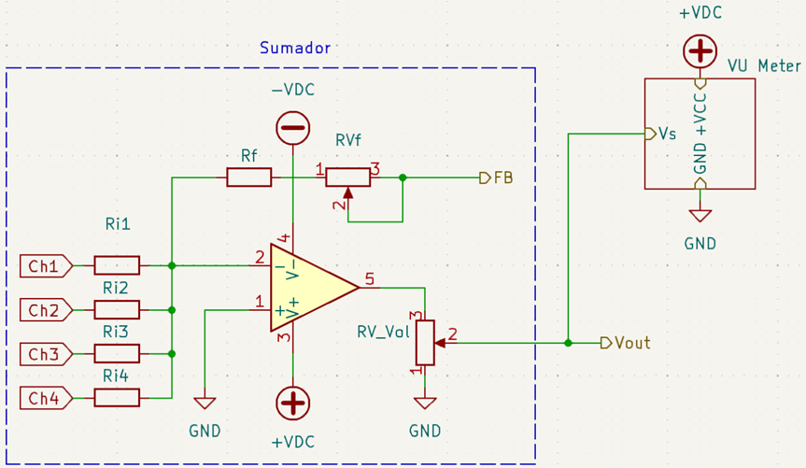
[picture p53: figure]

## Amplificador clase AB

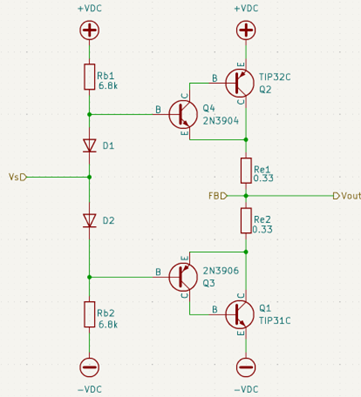
[picture p54: figure]

## Sumador

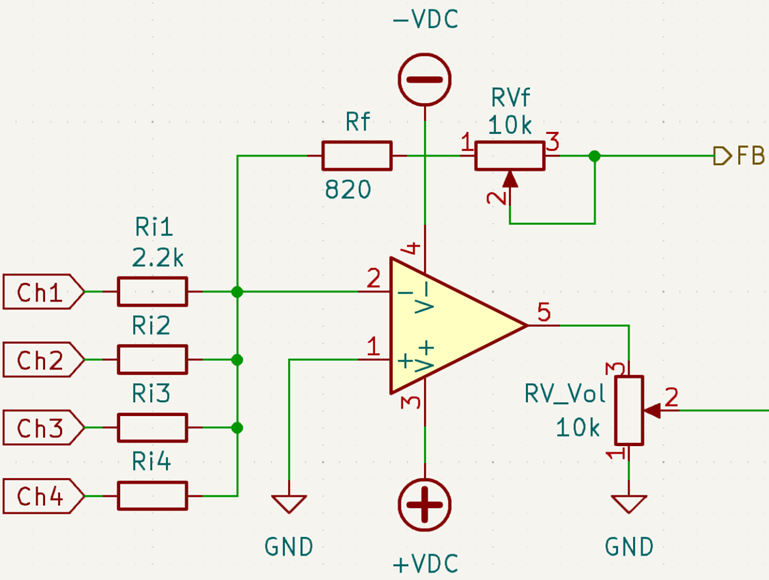
[picture p55: figure]

## Preamplificador para micrófono

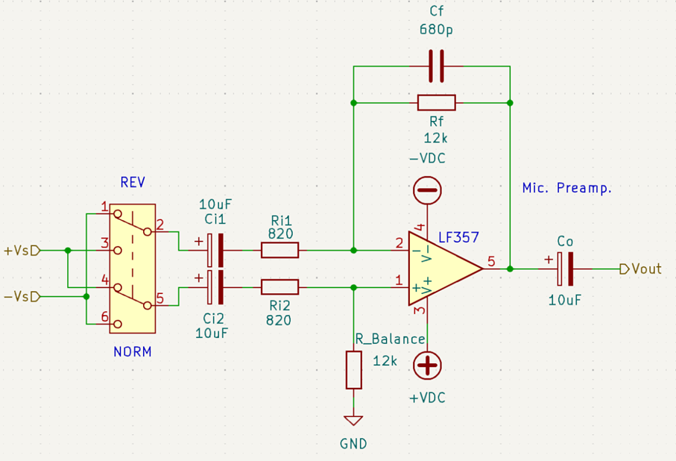
[picture p56: figure]

## Preamplificador de instrumento

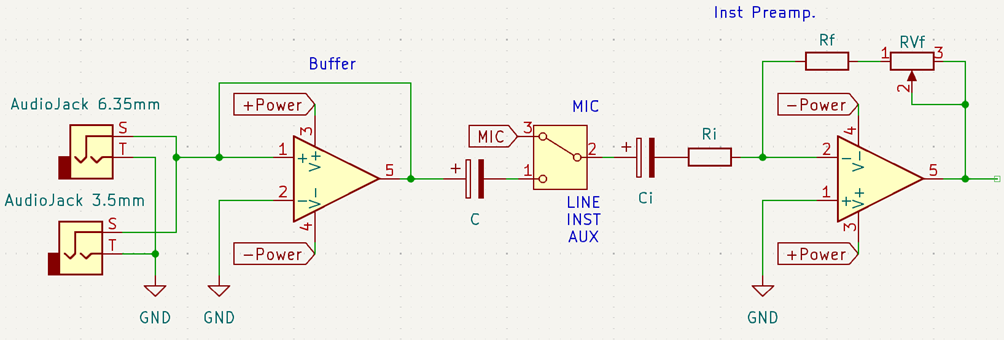
[picture p57: figure]

## Preamplificador de instrumento

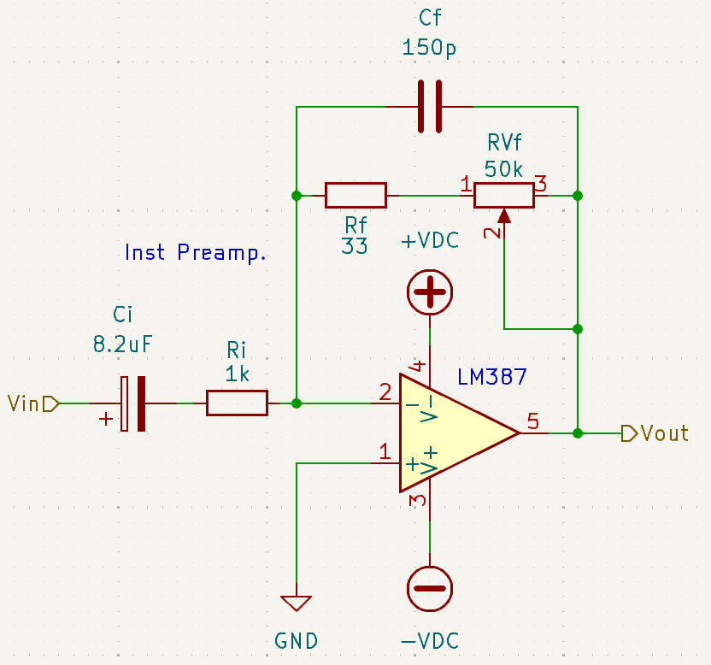
[picture p58: figure]

## Control de tonos

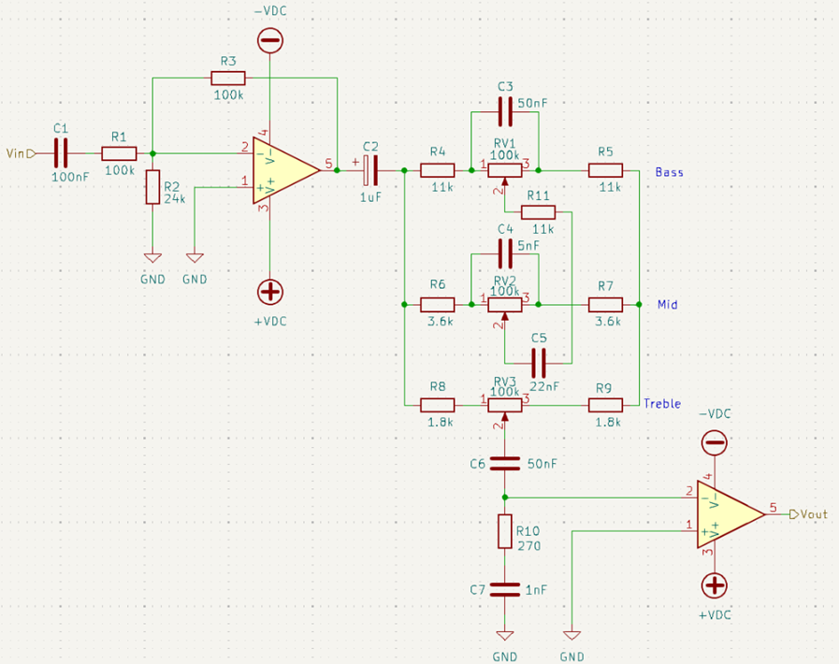
[picture p59: figure]

## Atenuador (“Fader”)

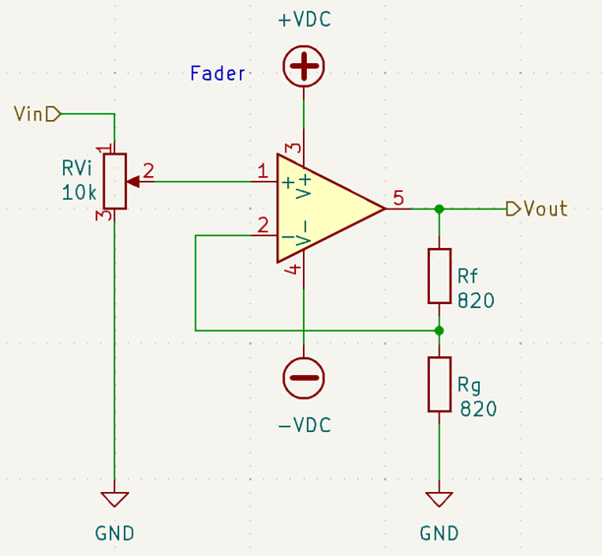
[picture p60: figure]

## Detector de picos bipolar

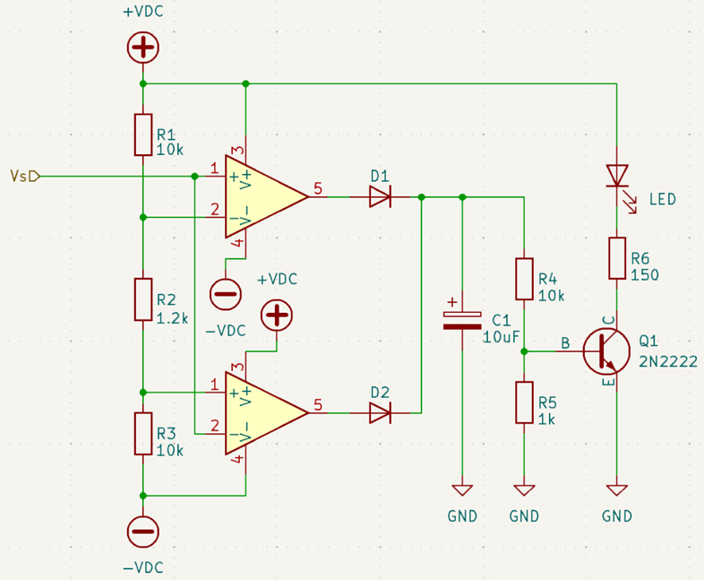
[picture p61: figure]

## Amplificador auriculares

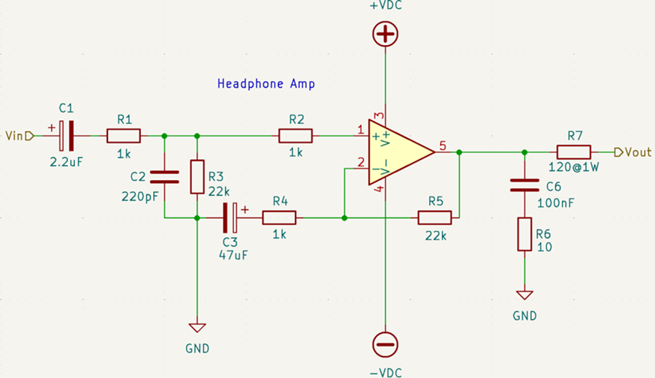
[picture p62: figure]

## VU Meter

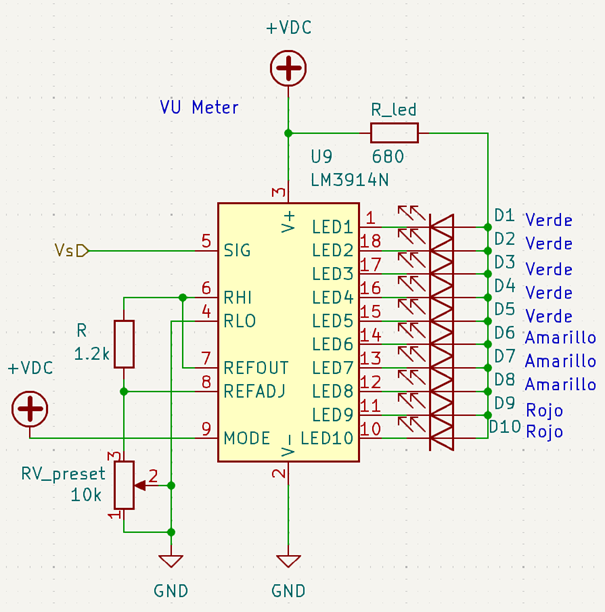
[picture p63: figure]

## Rectificador y filtro

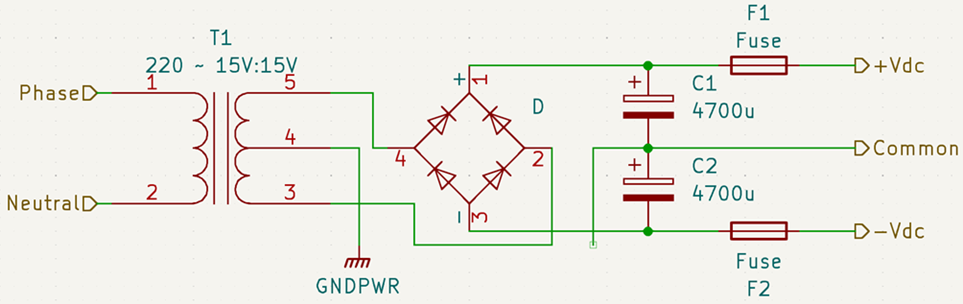
[picture p64: figure]

## Regulador

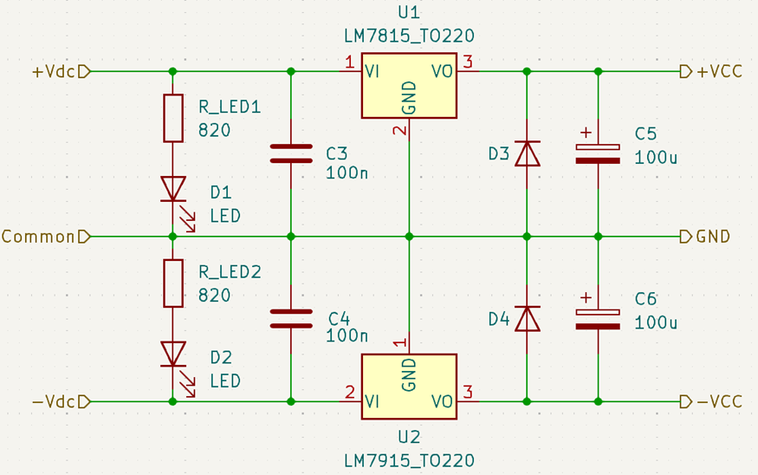
[picture p65: figure]

## Muchas gracias
