Exequiel25/Mezclador-de-4-canales-y-Amplificador-de-3W/Circuitos/Simulaciones/Class AB & Master Mixer/Respuesta en el tiempo.png

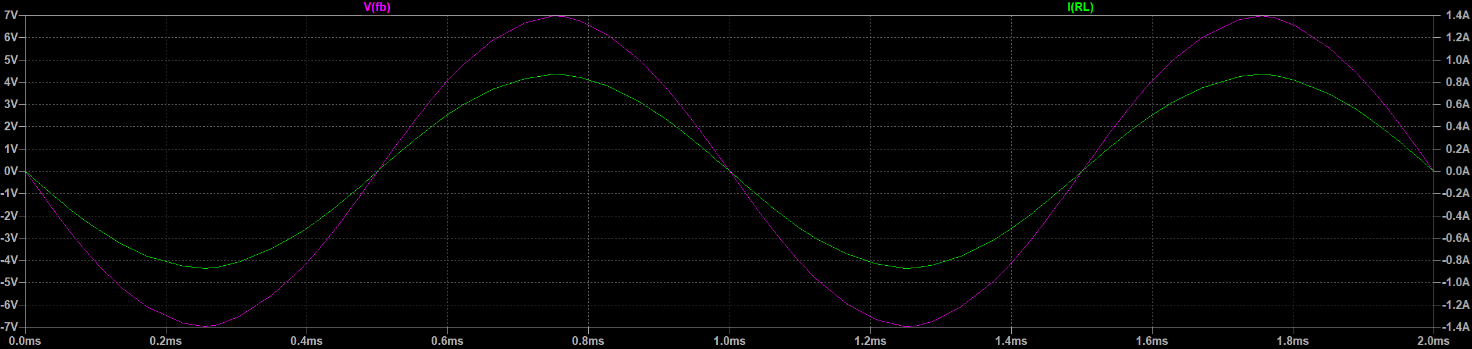
Circuitos/Simulaciones/Class AB & Master Mixer/Respuesta en el tiempo.png
