Exequiel25/Mezclador-de-4-canales-y-Amplificador-de-3W/Circuitos/Simulaciones/Fader/Respuesta en el tiempo.png

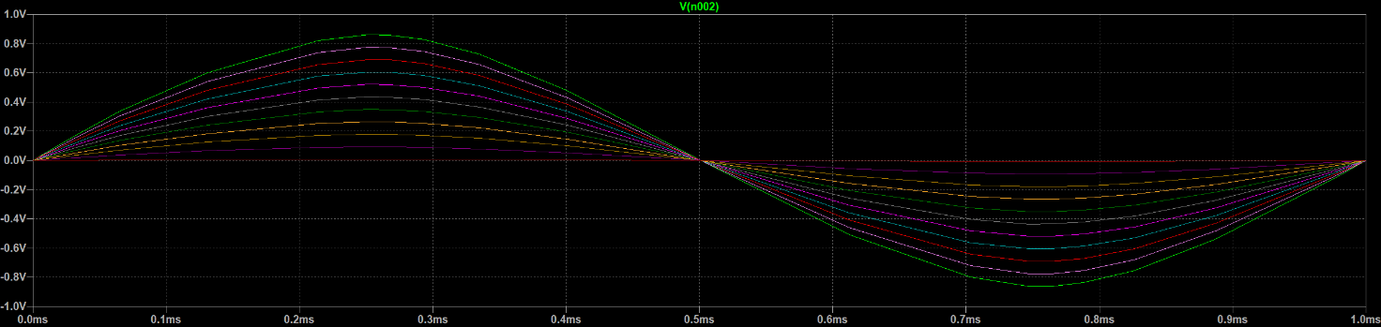
Circuitos/Simulaciones/Fader/Respuesta en el tiempo.png
