Exequiel25/Mezclador-de-4-canales-y-Amplificador-de-3W/Circuitos/Simulaciones/Master Mixer/Respuesta en frecuencia-Posibles valores.png

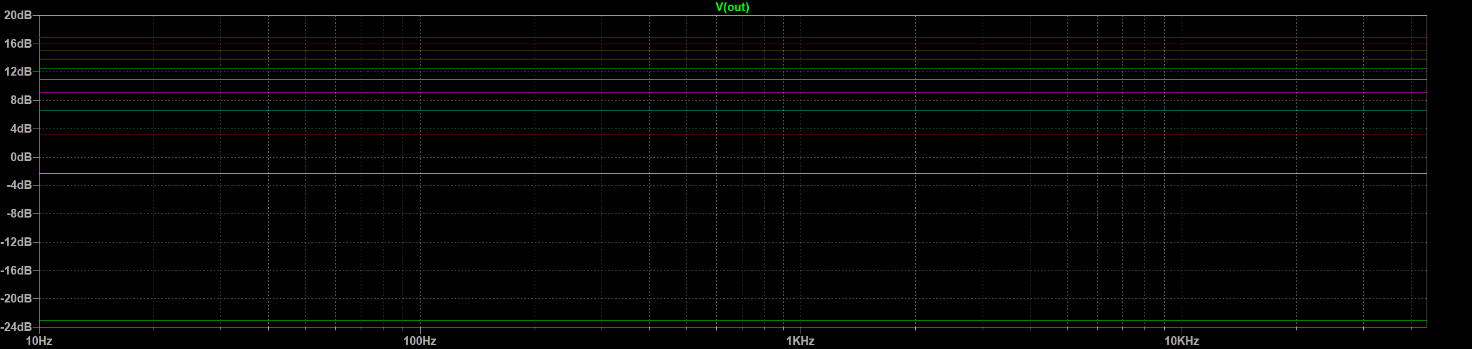
Circuitos/Simulaciones/Master Mixer/Respuesta en frecuencia-Posibles valores.png
