Exequiel25/Mezclador-de-4-canales-y-Amplificador-de-3W/Circuitos/Simulaciones/Mic Preamp/Respuesta en el tiempo.png

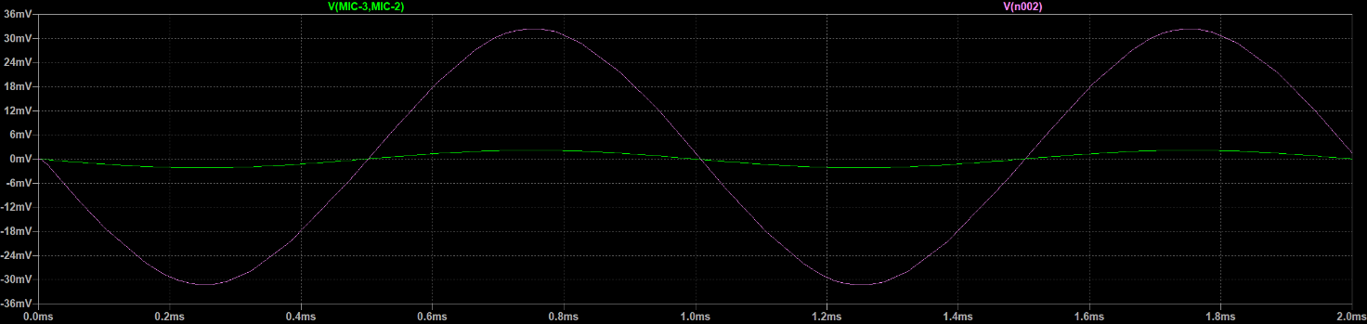
Circuitos/Simulaciones/Mic Preamp/Respuesta en el tiempo.png
