Exequiel25/Mezclador-de-4-canales-y-Amplificador-de-3W/Circuitos/Simulaciones/Mic Preamp/Respuesta en frecuencia.png

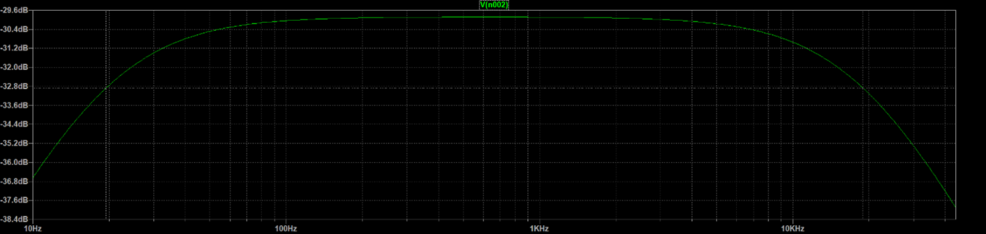
Circuitos/Simulaciones/Mic Preamp/Respuesta en frecuencia.png
