Exequiel25/Mezclador-de-4-canales-y-Amplificador-de-3W/Circuitos/Simulaciones/Power Supply/Salida rectificador.png

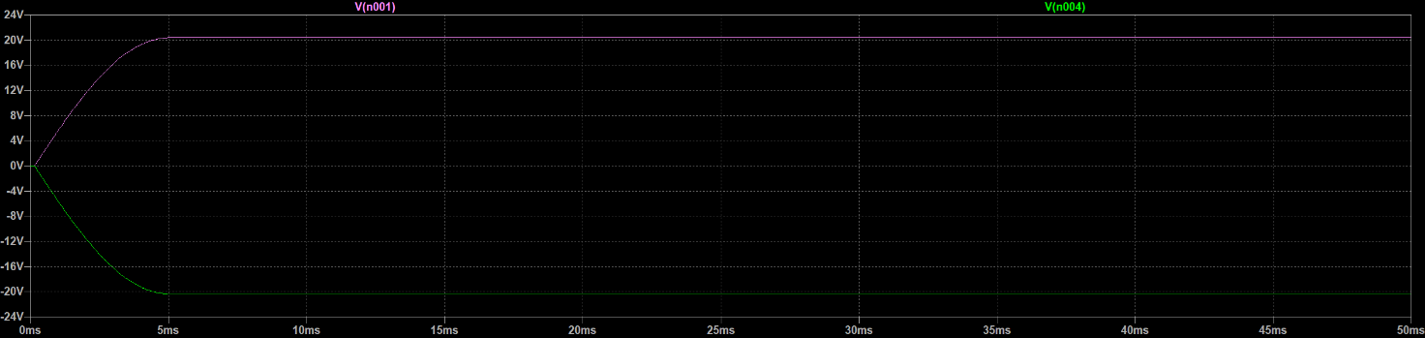
Circuitos/Simulaciones/Power Supply/Salida rectificador.png
