Exequiel25/Mezclador-de-4-canales-y-Amplificador-de-3W/Presentación/embalamiento_termico-gif.gif

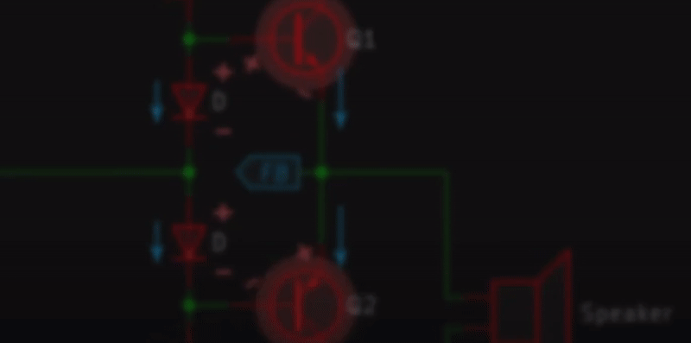
Presentación/embalamiento_termico-gif.gif
