Exequiel25/Mezclador-de-4-canales-y-Amplificador-de-3W/Presentación/img/Balanced-vs-Unbalanced-1.webp

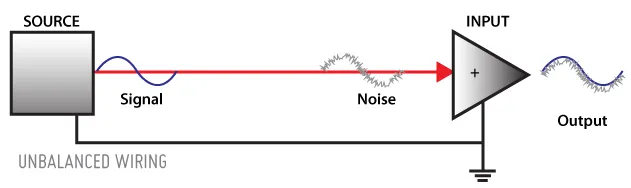
Presentación/img/Balanced-vs-Unbalanced-1.webp
