Exequiel25/Mezclador-de-4-canales-y-Amplificador-de-3W/Presentación/img/Balanced-vs-Unbalanced-2.webp

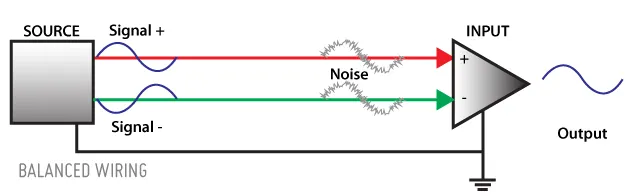
Presentación/img/Balanced-vs-Unbalanced-2.webp
