Exequiel25/Mezclador-de-4-canales-y-Amplificador-de-3W/Circuitos/Simulaciones/All together/Project with supply and Zobel.asc

C1: polcap; 10µ
C2: cap; 700p
C3: cap; 100n
C4: cap; 100p
C5: cap; 5n
C6: cap; 1n
C7: cap; 22n
C8: cap; 5n
C9: polcap; 1µ
C10: cap; 50n
C11: cap; 100n
C12: cap; 150p
C13: polcap; 2.2µ
C14: cap; 600p
C15: polcap; 10µ
C16: polcap; 10µ
C17: cap; 100n
C18: polcap; 1000µ
C19: cap; 47n
C20: cap; 15n
C21: polcap; 1µ
C22: cap; 100p
C23: cap; 5n
C24: cap; 1n
C25: cap; 22n
C26: cap; 5n
C27: cap; 50n
C28: polcap; 1µ
C29: cap; 100n
C30: cap; 150p
C31: polcap; 2.2µ
C32: cap; 600p
C33: polcap; 10µ
C34: polcap; 10µ
C35: cap; 100p
C36: cap; 5n
C37: cap; 1n
C38: cap; 22n
C39: cap; 5n
C40: cap; 50n
C41: polcap; 1µ
C42: cap; 100n
C43: cap; 150p
C44: polcap; 2.2µ
C45: cap; 600p
C46: polcap; 10µ
C47: polcap; 10µ
C48: cap; 100p
C49: cap; 5n
C50: cap; 1n
C51: cap; 22n
C52: cap; 5n
C53: cap; 50n
C54: polcap; 1µ
C55: cap; 100n
C56: cap; 150p
C57: polcap; 2.2µ
C58: cap; 600p
C59: polcap; 10µ
C60: polcap; 10µ
C61: polcap; 12000µ
C62: polcap; 12000µ
D1: diode
D2: diode
D3: diode
D4: diode
D5: LED
D6: diode
D7: diode
D8: LED
D9: diode
D10: diode
D11: LED
D12: diode
D13: diode
D14: LED
D15: zener; UMZ5_1N
D16: zener; UMZ5_1N
D17: diode
D18: diode
D19: diode
D20: diode
D21: zener; UMZ5_1N
L1: ind; 99m
L2: ind; 99m
L3: ind; {Lp}
L4: ind; {Ls}
L5: ind; {Ls}
Q1: pnp; TIP32C
Q2: npn; 2N3904
Q3: npn; TIP31C
Q4: pnp; 2N3906
Q5: npn; BC337-25
Q6: pnp; BC327-25
Q7: pnp; BC327-25
Q8: pnp; BC327-25
Q9: pnp; BC327-25
Q10: npn; BC337-25
Q11: npn; BC337-25
Q12: pnp; BC327-25
Q13: npn; BC337-25
Q14: npn; BC337-25
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
.MODEL TIP31C NPN(
+ IS=1.62181E-13 ISE=1.75416E-11 ISC=4.36516E-14 XTI=3
+ BF=25 BR=20.607 IKF=6.98433 IKR=0.997156 XTB=1.5301
+ VAF=110.5 VAR=159.374 VJE=0.636 VJC=0.408 RE=0.56
+ RC=0.96 RB=164.793 RBM=0.100291 IRB=1.24287E-7
+ CJE=4.77E-10 CJC=7.29E-11 XCJC=0.589205 FC=0.5
+ NF=0.9899 NR=0.989511 NE=1.95 NC=1.014 MJE=0.327
+ MJC=0.339 TF=2.3733E-8 TR=1.0000E-8 ITF=1 VTF=10
+ XTF=10 EG=1.1605 KF=1E-9 AF=1 VCEO=100 ICRATING=3
+ MFG=NSC-FAIRCHILD)
.model 2N3906 PNP(
+ IS=1E-14 VAF=100 BF=100 IKF=0.4 XTB=1.5 BR=4 CJC=4.5E-12
+ CJE=10E-12 RB=20 RC=0.1 RE=0.1 TR=250E-9 TF=350E-12
+ ITF=1 VTF=2 XTF=3 Vceo=40 Icrating=200m mfg=NXP)
.MODEL TIP32C PNP(
+ IS=6.77594E-13 ISE=1.31133E-11 ISC=1.31133E-11 XTI=3
+ BF=25 BR=25.4966 IKF=0.891251 IKR=0.410482 XTB=1.2648
+ VAF=77.429 VAR=70.9603 VJE=0.59 VJC=0.5 RE=0.06 RC=0.16
+ RB=161.0 RBM=3.097 IRB=3.548134E-5 CJE=2.7E-10 CJC=1.07E-10
+ XCJC=0.589205 FC=0.5 NF=1.001 NR=1.004 NE=1.98 NC=1.12
+ MJE=0.319 MJC=0.352 TF=2.3733E-8 TR=1.0000E-8 ITF=1 VTF=10
+ XTF=10 EG=1.0863 VCEO=100 ICRATING=3 MFG=TEXAS)
.param vol=.001
.param gain=1
.param Rf1=RVf*gain
.param Rf2=RVf*(1-gain)
.param Vol1=10k*vol
.param Vol2=10k*(1-vol)
.OPTIONS ALLOW_AMBIGUOUS_MODELS
.param RVf=10k
.param Ri=2.7k
.param fader=.09
.param Rfader1=Rfader*fader
.param Rfader2=Rfader*(1-fader)
.param Rfader=10k
.param Rb1=bass_pot*bass_pot_dev/100
.param Rb2=bass_pot*(1-bass_pot_dev/100)
.param Rm1=mid_pot*mid_pot_dev/100
.param Rm2=mid_pot*(1-mid_pot_dev/100)
.param Rt1=treble_pot*treble_pot_dev/100
.param Rt2=treble_pot*(1-treble_pot_dev/100)
.param bass_pot=100k
.param mid_pot=100k
.param treble_pot=500k
.param bass_pot_dev=50
.param mid_pot_dev=50
.param treble_pot_dev=50
.param Rfp=50k
.param Rf3=Rfp*gain_p
.param Rf4=Rfp*(1-gain_p)
.param gain_p=1
MIC
PREAMP
TONE CONTROL
FADER
PEAK DETECTOR
.param RVbe=1k
.param Rbb1=RVbe*preset
.param Rbb2=RVbe*(1-preset)
.param preset=.47
MIC
PREAMP
TONE CONTROL
FADER
PEAK DETECTOR
MIC
PREAMP
TONE CONTROL
FADER
PEAK DETECTOR
MIC
PREAMP
TONE CONTROL
FADER
PEAK DETECTOR
K1 L1 L2 L3 1
.param Lp=10m
.param Ls=Lp/336
