Exequiel25/Mezclador-de-4-canales-y-Amplificador-de-3W/Circuitos/Simulaciones/Headphones Amp/Headphones Amp Freq.asc

C1: cap; 47n
C3: polcap; 1000µ
C4: polcap; 1µ
C5: polcap; 15n
Q1: pnp; BC327-25
Q2: npn; BC337-25
Q3: npn; BC337-25
Q4: npn; BC337-25
Q5: pnp; BC327-25
Q6: pnp; BC327-25
Q7: pnp; BC327-25
Q8: pnp; BC327-25
Q9: pnp; BC327-25
Q10: npn; BC337-25
Q11: npn; BC337-25
Q12: pnp; BC327-25
Q13: pnp; BC327-25
Q14: pnp; BC327-25
R1: res; 680
R2: res; 2.7k
R3: res; 0.33
R4: res; 0.33
R5: res; {R1}
R6: res; {R2}
R7: res; 150k
R8: res; 510k
R9: res; 82k
R10: res; 150k
R11: res; 2.7k
R12: res; 2.7k
R13: res; 470
R14: res; 1410
R15: res; 2.7k
R16: res; 2.7k
RL: res; 8
U1: UniversalOpAmp
V3: voltage; 8
Vin1: voltage; AC 434.16m
Vin2: voltage; AC 434.16m
Vin3: voltage; AC 434.16m
Vin4: voltage; AC 434.16m
Named nets: -Power, +Power, 0, Vs1, Vout, Vs2, Vs3, Vs4, vin
.param RVf=1k
.param R1=RVf*preset
.param R2=RVf*(1-preset)
;.step param preset .01 .99 .1
.param preset=.47
original Rf=1410
.ac dec 100 10 44k
