Exequiel25/Mezclador-de-4-canales-y-Amplificador-de-3W/Circuitos/Simulaciones/Power Supply/Power Supply - No IC - Headphones.asc

C1: polcap; 12000µ
D1: diode
D2: diode
D3: diode
D4: diode
D5: zener; UMZ5_1N
L1: ind; {Lp}; Rser=1m
L2: ind; {Ls}; Rser=1m
L3: ind; {Ls}; Rser=1m
Q1: npn
Q2: npn
R1: res; 3k
R2: res; 5.1k
R3: res; 5.6
RL: res; 80
RS: res; 10k
U1: UniversalOpamp
V1: voltage; SINE(0 311.127 50); Rser=.1
Named nets: 0, +Vreg, V-
.tran 50ms
K1 L1 L2 L3 1
.param Lp=10m
.param Ls=Lp/336
