Exequiel25/Mezclador-de-4-canales-y-Amplificador-de-3W/Circuitos/Simulaciones/Power Supply/Power Supply.asc

C1: polcap; 12000µ
C2: polcap; 12000µ
C3: cap; 100n
C4: cap; 100n
C5: polcap; 1µ; Rser=1
C6: polcap; 1µ; Rser=.5
D1: diode
D2: diode
D3: diode
D4: diode
D5: LED
D6: LED
D7: diode
D8: diode
L1: ind; {Lp}; Rser=1m
L2: ind; {Ls}; Rser=1m
L3: ind; {Ls}; Rser=1m
R1: res; 680
R2: res; 680
R3: res; 48
U1: LM7812
U2: 7912
V1: voltage; SINE(0 311.127 50); Rser=.1
Named nets: 0
.tran 50ms
K1 L1 L2 L3 1
.param Lp=10m
.param Ls=Lp/336
