Exequiel25/Mezclador-de-4-canales-y-Amplificador-de-3W/Circuitos/Simulaciones/Fader/Fader Freq.asc

R1: res; {Ra}
R2: res; {Rb}
Rf: res; 82
Rg: res; 820
U1: UniversalOpAmp
V1: voltage; 12
V2: voltage; 12
V3: voltage; AC 434.16m
Named nets: 0, -Power, +Power, Vs
;.param volume=.5
.step param volume .001 .99 .1
.param Rb=10k*(1-volume)
.param Ra=10k*volume
.ac dec 100 10 100000k
