Exequiel25/Mezclador-de-4-canales-y-Amplificador-de-3W/Circuitos/Simulaciones/Fader/Fader.asc

R1: res; {Ra}
R2: res; {Rb}
Rf: res; 82
Rg: res; 820
U1: UniversalOpAmp
V1: voltage; 12
V2: voltage; 12
V3: voltage; SINE(0 434.16m 1k)
Named nets: 0, -Power, +Power, Vs
;.param volume=.5
.tran 1ms
.step param volume .001 .99 .1
.param Rb=10k*(1-volume)
.param Ra=10k*volume
