Exequiel25/Mezclador-de-4-canales-y-Amplificador-de-3W/Circuitos/Simulaciones/Master Mixer/Master Mixer Freq.asc

C1: polcap; 10µF
C2: cap; 700p
R1: res; 2.7k
R2: res; 1k
R3: res; 2.7k
R4: res; {Rf1}
R5: res; {Rf2}
R6: res; {Rv1}
R7: res; {Rv2}
R8: res; 2.7k
R9: res; 2.7k
U1: UniversalOpAmp
V1: voltage; 12
V2: voltage; 12
V3: voltage; AC 434.16m
V4: voltage; AC 434.16m
V5: voltage; AC 434.16m
V6: voltage; AC 434.16m
Named nets: +Power, -Power, 0, Ch1, Ch2, Out, Ch3, Ch4
.step param gain .01 .99 .1
.step param fader .01 .99 .1
.param Rf1=RVf*gain
.param Rv1=10k*fader
.param Rf2=RVf*(1-gain)
.param Rv2=10k*(1-fader)
.param RVf=10k
.ac dec 100 10 44k
;.param gain=.99
;.param fader=.01
