Exequiel25/Mezclador-de-4-canales-y-Amplificador-de-3W/Circuitos/Simulaciones/Master Mixer/Master Mixer.asc

C1: cap; 700p
C2: polcap; 10µ
R1: res; 2.7k
R2: res; 1k
R3: res; 2.7k
R4: res; {Rf1}
R5: res; {Rf2}
R6: res; {Rv1}
R7: res; {Rv2}
R8: res; 2.7k
R9: res; 2.7k
U1: UniversalOpAmp
V1: voltage; 12
V2: voltage; 12
V3: voltage; SINE(0 434.16m 1k)
V4: voltage; SINE(0 434.16m 1k)
V5: voltage; SINE(0 434.16m 1k)
V6: voltage; SINE(0 434.16m 1k)
Named nets: +Power, -Power, 0, Ch1, Ch2, Out, Ch3, Ch4, vs
.step param gain .01 .99 .1
.tran 2ms
;.step param fader .01 .99 .1
.param Rf1=10k*gain
.param Rv1=10k*fader
.param Rf2=10k*(1-gain)
.param Rv2=10k*(1-fader)
.param fader=.01
;.param gain=.99
