Exequiel25/Mezclador-de-4-canales-y-Amplificador-de-3W/Circuitos/Simulaciones/Mic Preamp/Mic Preamp Freq.asc

C1: polcap; 10µ
C2: polcap; 10µ
C4: cap; 600p
Rf: res; 12.82k
Rg: res; 12k
Ri1: res; 820
Ri2: res; 820
U1: UniversalOpAmp
V2: voltage; ""; AC 1.096m 0
V3: voltage; ""; AC 1.096m 180
Vcc: voltage; 12
Vdd: voltage; 12
Named nets: +Power, -Power, 0, MIC-2, MIC-3, MIC-1, vout
.ac dec 100 10 44k
