Exequiel25/Mezclador-de-4-canales-y-Amplificador-de-3W/Circuitos/Simulaciones/Peak Detector/Peak Detector.asc

C1: cap; 100p
D1: diode
D2: diode
D3: LED
R1: res; 120
R2: res; 1.5k
R3: res; 1.5k
R4: res; 10k
U1: UniversalOpAmp
U2: UniversalOpAmp
V1: voltage; 12
V2: voltage; 12
V3: voltage; SINE(0 470m 1k)
Named nets: +Power, Vs, -Power, 0
.tran 0 .001 0 .1
