Exequiel25/Mezclador-de-4-canales-y-Amplificador-de-3W/Circuitos/Simulaciones/Preamp/Preamp.asc

12: voltage; 15
C1: polcap; 2.2µ
C2: cap; 150p
R1: res; 390
R2: res; 3.9k
R3: res; {R1}
R4: res; {R2}
U1: UniversalOpAmp
V1: voltage; 12
V3: voltage; SINE(0 34.65m 1k)
Named nets: +Power, -Power, 0, Vs, out
.tran 2ms
.param RVf=50k
.param R1=RVf*gain
.step param gain .01 .99 .1
.param R2=RVf*(1-gain)
