Exequiel25/Mezclador-de-4-canales-y-Amplificador-de-3W/Circuitos/Simulaciones/Tone Control/Tone Control.asc

C1: cap; 100n
C2: polcap; 1µ
C3: cap; 50n
C4: cap; 5n
C5: cap; 22n
C6: cap; 5n
C7: cap; 1n
R1: res; 100k
R2: res; 100k
R3: res; 24k
R4: res; 11k
R5: res; {Rb1}
R6: res; {Rb2}
R7: res; 11k
R8: res; 11k
R9: res; 3.6k
R10: res; {Rm1}
R11: res; {Rm2}
R12: res; 3.6k
R13: res; 1.8k
R14: res; {Rt1}
R15: res; {Rt2}
R16: res; 1.8k
R17: res; 270
U1: UniversalOpAmp
U2: UniversalOpAmp
V1: voltage; 12
V2: voltage; 12
V3: voltage; ""; AC 1
Named nets: +Power, -Power, 0, Line, vout
.ac dec 100 10 25k
.param bass_pot=100k
.param mid_pot=100k
.param treble_pot=500k
.param bass_pot_dev=50
.param mid_pot_dev=50
;.param treble_pot_dev=50
Bass
Midrange
Treble
.step param treble_pot_dev 1 99 10
;.step param mid_pot_dev 1 99 10
;.step param bass_pot_dev 1 99 10
.param Rb2=bass_pot*(1-bass_pot_dev/100)
.param Rb1=bass_pot*bass_pot_dev/100
.param Rm2=mid_pot*(1-mid_pot_dev/100)
.param Rm1=mid_pot*mid_pot_dev/100
.param Rt2=treble_pot*(1-treble_pot_dev/100)
.param Rt1=treble_pot*treble_pot_dev/100
