Exequiel25/Mezclador-de-4-canales-y-Amplificador-de-3W/Circuitos/Simulaciones/Class AB/Power Amp - Con error.asc

Q1: npn; 2N3904
Q3: pnp; 2N3906
R1: res; 1k
R2: res; 1k
RL: res; 8
V3: voltage; 15
V4: voltage; 15
Vin: voltage; SINE(0 5 1k)
Named nets: -Power, +Power, 0, Vs
.tran 0 .002 0 .01
