Exequiel25/Mezclador-de-4-canales-y-Amplificador-de-3W/Circuitos/Simulaciones/Class AB/Power Amp-ori.asc

C1: polcap; 4700µ
D1: diode
D2: diode
D3: diode
D4: diode
Q1: npn; TIP31
Q2: pnp; TIP32
Q3: pnp; 2N3906
Q4: npn; 2N3904
Q5: npn; 2N3904
Rb1: res; {rb}
Rb2: res; {rb}
Rbe: res; 33k
Re1: res; {re}
Re2: res; {re}
RL: res; 8
Rtr1: res; {rtr}
Rtr2: res; {rtr}
U1: pot_; wiper={bias}
V3: voltage; 15
V4: voltage; 15
Vin: voltage; SINE(0 5 1k)
Named nets: -Power, +Power, 0
.model TIP31 NPN (IS=1E-14 BF=25 NF=1.0 VAF=100)
.model TIP32 PNP (IS=1E-14 BF=25 NF=1.0 VAF=100)
.model 2N3906 PNP (IS=1E-14 BF=50 NF=1.0 VAF=100)
.model 2N3904 NPN (IS=1E-14 BF=50 NF=1.0 VAF=100)
.tran 0 .002 0 .01
.param rb=3.3k
.param re=33
.param rtr=.33
;.step param bias .01 .99 .1
.param bias=.5
