Exequiel25/Mezclador-de-4-canales-y-Amplificador-de-3W/Circuitos/Mixer 4 Channels with Power Amplifier/Mixer 4 Channels with Power Amplifier.kicad_pcb

## KiCad design PCB/PCB.kicad_sch

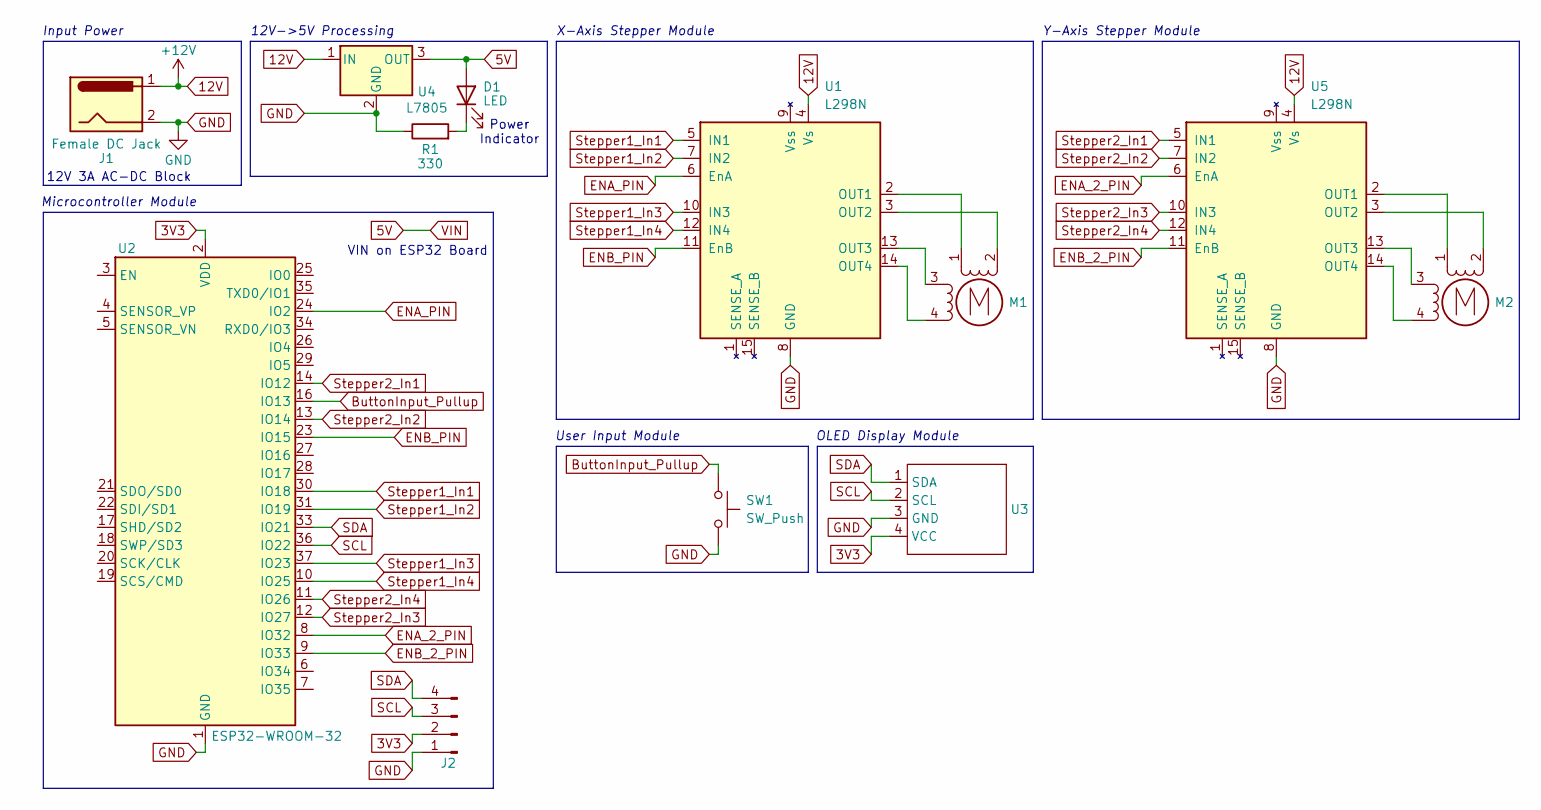
[picture p75: schematic PCB.kicad_sch]

Parts:
D1: LED; LED_1206_3216Metric
J1: Female DC Jack
J2: Conn_01x04_Pin; PinHeader_1x04_P2.54mm_Vertical
M1, M2: Stepper_Motor_bipolar
R1: 330; R_1206_3216Metric
SW1: SW_Push
U1, U5: L298N; TO-220-15_P2.54x2.54mm_StaggerOdd_Lead4.58mm_Vertical
U2: ESP32-WROOM-32
U3: (no value)
U4: L7805

Connections:
3V3: J2.2, U2.2 (VDD), U3.4 (VCC)
5V: D1.2 (A), U4.3 (OUT)
+12V: J1.1, U1.4 (Vs), U4.1 (IN), U5.4 (Vs)
ButtonInput_Pullup: SW1.1, U2.16 (IO13)
ENA_2_PIN: U2.8 (IO32), U5.6 (EnA)
ENA_PIN: U1.6 (EnA), U2.24 (IO2)
ENB_2_PIN: U2.9 (IO33), U5.11 (EnB)
ENB_PIN: U1.11 (EnB), U2.23 (IO15)
GND: J1.2, J2.1, R1.1, SW1.2, U1.8 (GND), U2.1 (GND), U2.15 (GND), U2.38 (GND), U2.39 (GND), U3.3 (GND), U4.2 (GND), U5.8 (GND)
unnamed: D1.1 (K), R1.2
unnamed: M1.1, U1.2 (OUT1)
unnamed: M1.2 (-), U1.3 (OUT2)
unnamed: M1.3, U1.13 (OUT3)
unnamed: M1.4, U1.14 (OUT4)
unnamed: M2.1, U5.2 (OUT1)
unnamed: M2.2 (-), U5.3 (OUT2)
unnamed: M2.3, U5.13 (OUT3)
unnamed: M2.4, U5.14 (OUT4)
SCL: J2.3, U2.36 (IO22), U3.2 (SCL)
SDA: J2.4, U2.33 (IO21), U3.1 (SDA)
Stepper1_In1: U1.5 (IN1), U2.30 (IO18)
Stepper1_In2: U1.7 (IN2), U2.31 (IO19)
Stepper1_In3: U1.10 (IN3), U2.37 (IO23)
Stepper1_In4: U1.12 (IN4), U2.10 (IO25)
Stepper2_In1: U2.14 (IO12), U5.5 (IN1)
Stepper2_In2: U2.13 (IO14), U5.7 (IN2)
Stepper2_In3: U2.12 (IO27), U5.10 (IN3)
Stepper2_In4: U2.11 (IO26), U5.12 (IN4)

Notes on the sheet:
OLED Display Module
Y-Axis Stepper Module
Microcontroller Module
Input Power
X-Axis Stepper Module
VIN on ESP32 Board
12V->5V Processing
Power Indicator
User Input Module
12V 3A AC-DC Block
