Exequiel25/Mezclador-de-4-canales-y-Amplificador-de-3W/(commit log)

2025-02-09 Informe de proyecto
2025-02-09 Hojas de datos
2025-02-09 Esquemático KiCad Amplificador clase AB
    [Amplificador de Potencia.kicad_pcb, Amplificador de Potencia.kicad_sch]
2025-02-09 Esquemático KiCad Fuente
    [Fuente de Alimentación.kicad_pcb, Fuente de Alimentación.kicad_sch]
2025-02-09 Esquemático KiCad Mezclador
    [Mezclador de Audio.kicad_pcb, Mezclador de Audio.kicad_sch]
2025-02-09 Esquemático Completo en KiCad
    [Class AB Power Amplifier.kicad_sch, Fader.kicad_sch, Headphones Amplifier.kicad_sch, Line-Instrument-AUX Input.kicad_sch, Microphone Input.kicad_sch, Mixer 4 Channels with Power Amplifier.kicad_pcb, Mixer 4 Channels with Power Amplifier.kicad_sch, Mixer.kicad_sch]
2025-02-10 Correcciones pequeñas y eliminación duplicados
    [Amplificador de Potencia.kicad_sch]
2025-02-12 Correcciones en etapas y respaldo fotos simulación
    [Mixer.kicad_sch, Preamplifier.kicad_sch]
2025-02-24 Correcciones y modificaciones en fuente, amp auriculares y simul completa
    [Class AB Power Amplifier.kicad_sch, Fader.kicad_sch, Headphones Amplifier.kicad_sch, Mezclador de Audio.kicad_sch, Microphone Input.kicad_sch, Mixer.kicad_sch, Peak Detector.kicad_sch, Rectificador y Filtro.kicad_sch]
2025-02-25 Informe finalizado
    [Headphones Amplifier.kicad_sch, Mixer 4 Channels with Power Amplifier.kicad_sch, Peak Detector.kicad_sch, Regulador.kicad_sch]
2025-02-26 Final de proyecto
    [Headphones Amplifier.kicad_sch, Regulador.kicad_sch, Tone Control.kicad_sch]
2025-07-06 Power Supply corrections
    [Fuente de Alimentación.kicad_sch]
